cracked-machine/STM32MP1_TestBoard_RevC/STM32MP1_TestBoard_RevC/doc/layout_render/STM32MP1_TestBoard_Back.png

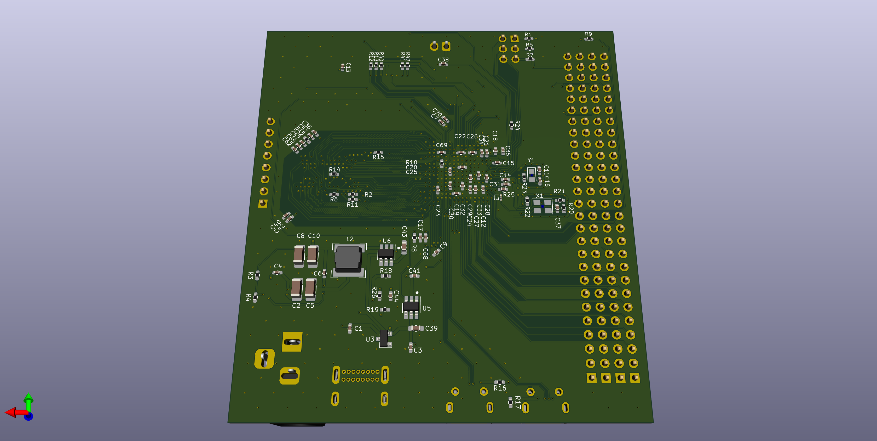
STM32MP1_TestBoard_RevC/doc/layout_render/STM32MP1_TestBoard_Back.png
