cracked-machine/STM32MP1_TestBoard_RevC/STM32MP1_TestBoard_RevC/doc/photos/STM32MP1_A7_boot.jpg

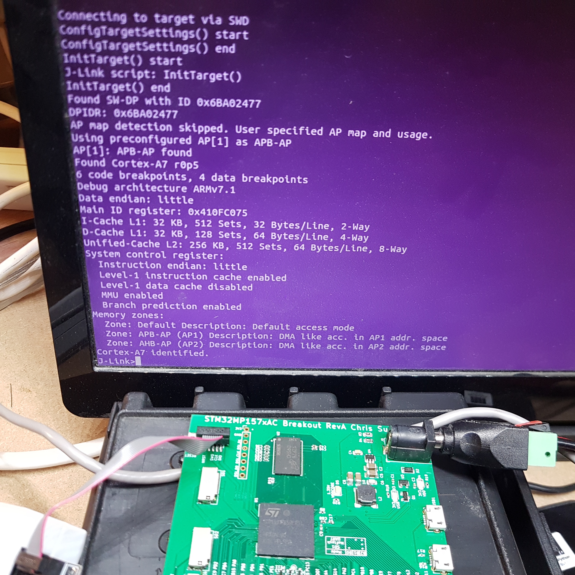
STM32MP1_TestBoard_RevC/doc/photos/STM32MP1_A7_boot.jpg
