cracked-machine/STM32MP1_TestBoard_RevC/STM32MP1_TestBoard_RevC/doc/datasheets/STM32MP1/mb1272_bom/MB1272C/MB1272-DK1-C01_BOM.xlsx

 |  |  | Bill of materials
 |  |  | Board reference: | MB1272
 |  |  | Variant: | DK1
 |  |  | PCB revision: | C
 |  |  | Assembly revision: | 01
 |  |  | Date: | 11/5/2018
Designator | Description | Package | Manufacturer | Manufacturer_Part_Number | Fitted | Quantity
B1, B3, B4 | Switch HW SMD blue |  | JIUBABA | C-TS-02H-2.5-B-V-T/R BLUE | Fitted | 3
B2 | Switch HW SMD black |  | JIUBABA | C-TS-02H-2.5-K-V-T/R BLACK | Fitted | 1
C1, C7, C12, C14, C17, C18, C22, C35, C36, C46, C47, C48, C51, C57, C61, C63, C67, C68, C70, C74, C75, C77, C78, C79, C81, C93, C95, C96, C97, C103, C107, C119, C120, C125, C126, C127, C128, C129, C130, C131, C132, C134, C135, C139, C140, C141, C142, C149, C154, C157, C160, C164, C168, C169, C170, C171, C172, C174, C175, C176, C177, C178, C179, C181, C182, C183, C184, C186, C187, C188 | Capacitor,100nF,16V,X7R,10%,0402, Capacitor,100nF,16V,X7R,10%,0402, Capacitor, MLCC, 100nF, 16V, X7R, 10%, 0402, T=0.5mm, Capacitor,100nF,16V,X7R,10%,0402, Capacitor,100nF,16V,X7R,10%,0402, Capacitor, MLCC, 100nF, 16V, X7R, 10%, 0402, T=0.5mm, Capacitor,100nF,16V,X7R,10%,0402, Capacitor,100nF,16V,X7R,10%,0402, Capacitor,100nF,16V,X7R,10%,0402, Capacitor,100nF,16V,X7R,10%,0402, Capacitor,100nF,16V,X7R,10%,0402, Capacitor,100nF,16V,X7R,10%,0402, Capacitor,100nF,16V,X7R,10%,0402, Capacitor,100nF,16V,X7R,10%,0402, Capacitor,100nF,16V,X7R,10%,0402, Capacitor, MLCC, 100nF, 16V, X7R, 10%, 0402, T=0.5mm, Capacitor, MLCC, 100nF, 16V, X7R, 10%, 0402, T=0.5mm, Capacitor,100nF,16V,X7R,10%,0402, Capacitor,100nF,16V,X7R,10%,0402, Capacitor,100nF,16V,X7R,10%,0402, Capacitor,100nF,16V,X7R,10%,0402, Capacitor,100nF,16V,X7R,10%,0402, Capacitor,100nF,16V,X7R,10%,0402, Capacitor,100nF,16V,X7R,10%,0402, Capacitor,100nF,16V,X7R,10%,0402, Capacitor,100nF,16V,X7R,10%,0402, Capacitor,100nF,16V,X7R,10%,0402, Capacitor,100nF,16V,X7R,10%,0402, Capacitor,100nF,16V,X7R,10%,0402, Capacitor,100nF,16V,X7R,10%,0402, Capacitor,100nF,16V,X7R,10%,0402, Capacitor,100nF,16V,X7R,10%,0402, Capacitor,100nF,16V,X7R,10%,0402, Capacitor,100nF,16V,X7R,10%,0402, Capacitor,100nF,16V,X7R,10%,0402, Capacitor,100nF,16V,X7R,10%,0402, Capacitor,100nF,16V,X7R,10%,0402, Capacitor,100nF,16V,X7R,10%,0402, Capacitor,100nF,16V,X7R,10%,0402, Capacitor,100nF,16V,X7R,10%,0402, Capacitor,100nF,16V,X7R,10%,0402, Capacitor,100nF,16V,X7R,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 | C0402 | YAGEO | CC0402KRX7R7BB104 | Fitted | 70
C10, C16, C20, C23, C26, C31, C32, C33, C49 | Capacitor, MLCC, 4.7uF, 6V3, X5R, 20%, 0402, T=0,5mm | C0402 | MURATA | GRM155R60J475ME47 | Fitted | 9
C100, C101 | Capacitor,150pF,50V,COG,5%,0603 | C0603 | YAGEO | CC0603JRNPO9BN151 | Fitted | 2
C104, C110 | Capacitor,1uF,16V,X5R,10%,0603 | C0603 | YAGEO | CC0603KRX5R7BB105 | Fitted | 2
C106, C113 | Capacitor,22nF,16V,X7R,10%,0402 | C0402 | YAGEO | CC0402KRX7R7BB223 | Fitted | 2
C111 | Capacitor,10uF,6V3,X5R,10%,0603 | C0603 | YAGEO | CC0603KRX5R5BB106 | Fitted | 1
C118, C124, C133, C138 | Capacitor, MLCC, 220uF, 6V3, X5R, 20%, 1206, T=1,6mm | C1206 | MURATA | GRM31CR60J227ME11 | Fitted | 4
C144, C145 | Capacitor,1nF,16V,X7R,10%,0402 | C0402 | YAGEO | CC0402KRX7R7BB102 | Fitted | 2
C15, C27, C39, C62, C64, C65, C72, C73, C89, C94, C102, C105, C108, C109, C112, C143, C146, C147, C148, C150, C152, C153, C155, C156, C158, C159, C161, C162, C163, C165, C191, C192 | Capacitor, MLCC, 1uF, 6V3, X5R, 10%, 0402, T=0,5mm, Capacitor, MLCC, 1uF, 6V3, X5R, 10%, 0402, T=0,5mm, Capacitor, MLCC, 1uF, 6V3, X5R, 10%, 0402, T=0,5mm, Capacitor, MLCC, 1uF, 6V3, X5R, 10%, 0402, T=0,5mm, Capacitor,1uF,6V3,X5R,10%,0402, Capacitor, MLCC, 1uF, 6V3, X5R, 10%, 0402, T=0,5mm, Capacitor,1uF,6V3,X5R,10%,0402, Capacitor,1uF,6V3,X5R,10%,0402, Capacitor,1uF,6V3,X5R,10%,0402, Capacitor,1uF,6V3,X5R,10%,0402, Capacitor,1uF,6V3,X5R,10%,0402, Capacitor,1uF,6V3,X5R,10%,0402, Capacitor,1uF,6V3,X5R,10%,0402, Capacitor,1uF,6V3,X5R,10%,0402, Capacitor,1uF,6V3,X5R,10%,0402, Capacitor,1uF,6V3,X5R,10%,0402, Capacitor,1uF,6V3,X5R,10%,0402, Capacitor,1uF,6V3,X5R,10%,0402, Capacitor,1uF,6V3,X5R,10%,0402, Capacitor,1uF,6V3,X5R,10%,0402, Capacitor,1uF,6V3,X5R,10%,0402, Capacitor,1uF,6V3,X5R,10%,0402, Capacitor,1uF,6V3,X5R,10%,0402, Capacitor,1uF,6V3,X5R,10%,0402, Capacitor,1uF,6V3,X5R,10%,0402, Capacitor,1uF,6V3,X5R,10%,0402, Capacitor,1uF,6V3,X5R,10%,0402, Capacitor,1uF,6V3,X5R,10%,0402, Capacitor,1uF,6V3,X5R,10%,0402, Capacitor,1uF,6V3,X5R,10%,0402, Capacitor,1uF,6V3,X5R,10%,0402, Capacitor,1uF,6V3,X5R,10%,0402 | C0402 | MURATA | GRM155R61E105KA12 | Fitted | 32
C185, C190 | Capacitor,1uF,6V3,X5R,10%,0603 | C0603 | YAGEO | CC0603KRX5R5BB105 | Fitted | 2
C2, C3, C42, C44, C76, C80, C85, C121, C122, C151, C173, C180 | Capacitor, MLCC, 22uF, 6V3, X5R, 20%, 0603, T=0,8mm, Capacitor, MLCC, 22uF, 6V3, X5R, 20%, 0603, T=0,8mm, Capacitor, MLCC, 22uF, 6V3, X5R, 20%, 0603, T=0,8mm, Capacitor, MLCC, 22uF, 6V3, X5R, 20%, 0603, T=0,8mm, Capacitor,22uF,6V3,X5R,20%,0603, Capacitor,22uF,6V3,X5R,20%,0603, Capacitor,22uF,6V3,X5R,20%,0603, Capacitor, MLCC, 22uF, 6V3, X5R, 20%, 0603, T=0,8mm, Capacitor, MLCC, 22uF, 6V3, X5R, 20%, 0603, T=0,8mm, Capacitor,22uF,6V3,X5R,20%,0603, Capacitor,22uF,6V3,X5R,20%,0603, Capacitor,22uF,6V3,X5R,20%,0603 | C0603 | MURATA | GRM188R60J226MEA0J | Fitted | 12
C21, C25, C30, C38, C40, C50, C53, C54, C56, C66, C117, C123, C136, C137 | Capacitor, MLCC, 100nF, 16V, X7R, 10%, 0402, T=0,5mm | C0402 | YAGEO | CC0402KRX7R7BB104 | Fitted | 14
C4, C5, C6, C9, C11, C13, C41, C43 | Capacitor, MLCC, 10uF, 10V, X5R, 10%, 0603, T=0,8mm | C0603 | MURATA | GRM188R61A106KE69D | Fitted | 8
C52 | Polarized Capacitor,10uF,16V,10%,typeA | C1206 | AVX | TAJA106K016R | Fitted | 1
C55 | Capacitor, MLCC, 47uF, 10V, X5R, 20%, 0805, T=1,25mm | C0805 | MURATA | GRM21BR61A476ME15K | Fitted | 1
C58, C59, C87, C88, C90, C91 | Capacitor, MLCC, 6.8pF, 50V, NPO, +-0.25pF, 0402, T=0.5mm | C0402 | YAGEO | CC0402CRNPO9BN6R8 | Fitted | 6
C60 | Capacitor, Tantalum, 47uF, 16V, 10%, TypeC | C2312 | AVX | TAJC476K016RNJ | Fitted | 1
C69, C167 | Capacitor, MLCC, 100pF, 50V, NPO, 5%, 0402, T=0,5mm | C0402 | YAGEO | CC0402JRNPO9BN101 | Fitted | 2
C71, C166 | Capacitor, MLCC, 10uF, 25V, X5R, 10%, 0805, T=0,85mm | C0805 | YAGEO | CC0805KRX5R8BB106 | Fitted | 2
C82, C86, C98, C99 | Capacitor,10pF,50V,NPO,5%,0402 | C0402 | YAGEO | CC0402JRNPO9BN100 | Fitted | 4
C83, C84 | Capacitor, MLCC, 470pF, 50V, NPO, 5%, 0402, T=0,5mm | C0402 | YAGEO | CC0402JRNPO9BN471 | Fitted | 2
C92, C114, C115, C189, C300 | Capacitor, MLCC, 10nF, 16V, X7R, 10%, 0402, T=0.5mm, Capacitor, MLCC, 10nF, 16V, X7R, 10%, 0402, T=0.5mm, Capacitor, MLCC, 10nF, 16V, X7R, 10%, 0402, T=0.5mm, Capacitor,10nF,16V,X7R,10%,0402, Capacitor, MLCC, 10nF, 16V, X7R, 10%, 0402, T=0.5mm | C0402 | YAGEO | CC0402KRX7R7BB103 | Fitted | 5
CN1, CN5 | USB-Receptacle,Dual-Type-A, RA, TH, Height 15.5mm |  | CONEXCON | 5600-3081 | Fitted | 2
CN10 | Connector Jack socket Stereo 3.5mm, 4 pins, RA, SMT, Black |  | LUMBERG | 1503 13 VP3 | Fitted | 1
CN11 | USB-MICRO-B, 0.65mm, RA, SMT, Bottom Mount, |  | MOLEX | 1050170001 | Fitted | 1
CN13 | Socket, 10x1, 2.54mm, VR, SMT, Height 9.78mm |  | SAMTEC | SSW-110-22-L-S-VS | Fitted | 1
CN14, CN16 | Socket, 8x1, 2.54mm, VR, SMT, Height 9.78mm |  | SAMTEC | SSW-108-22-L-S-VS | Fitted | 2
CN15 | MicroSD Card Conn, Reversed-Type, Mnt Push-Push |  | YAMAICHI | PJS008-2003-1 | Fitted | 1
CN17 | Socket, 6x1, 2.54mm, VR, SMT, Height 9.78mm |  | SAMTEC | SSW-106-22-L-S-VS | Fitted | 1
CN2 | Header, 20x2, 2.54mm, VR, TH, Height 5.84mm/2.54mm |  | SAMTEC | TSW-120-07-G-D | Fitted | 1
CN3 | Header 2 circuits, 1.25mm Pitch , Vertical, with Friction Lock |  | MOLEX | 53047-0210 | Fitted | 1
CN4 | Socket ,TEConn,FCC/FPC, 20pins, 1.0mm,SMT, ZIF Receptacle |  | TE CONNECTIVITY | 2-1734248-0 | Fitted | 1
CN6, CN7 | USB tyce C certified receptacle for 1.6mm pcb height |  | CHANT SINCERE (COXOC) | 317JD24BZTF3K3C3 | Fitted | 2
CN8 | Connector RJ45 with Gigabit magnetics and LED , led pull down |  | YUAN DEAN SCIENTIFIC | 48F-01GYDXNL | Fitted | 1
CN9 | HDMI Receptacle Type A 19pins standard Connector |  | FCI | 10029449-001RLF | Fitted | 1
D1, D2 | BAT60JFILM |  | STMICROELECTRONICS | BAT60JFILM | Fitted | 2
F1 | Surface mount resettable polyswitch fuse.I hold=0.35A and I trigger=0.75A | 0805 | TE CONNECTIVITY | picoSMDC035S | Fitted | 1
HW1300 | MICRO_SD_CARD Standard min 4GB |  | NETAC | SD_CARD | Fitted | 1
HW1301 | PCB, xxxx for PCB ref, Y for revision |  | n/a | n/a | Fitted | 1
HW1302 | Sticker to mention board CPN code |  | n/a | n/a | Fitted | 1
HW1303 | Sticker to mention board reference + serial number |  | n/a | n/a | Fitted | 1
L10, L11 | Ferrite bead 100R 2A 0603 |  | MURATA | BLM18EG101TN1 | Fitted | 2
L2, L3, L5, L6 | Power Inductor ,1µH,4.3A max,+-20%,0.042ohm,2520 | 2520 | MURATA | DFE252012P-1ROM=P2 | Fitted | 4
L7 | SMD Chip ferrite bead, 30R@100MHz +/-30%, 5A, 10mohm DC, S (Standard) material, 0603, T=0.8mm |  | TDK | MPZ1608S300A | Fitted | 1
L8 | Bead,26R at 100Mhz,6A,0603 |  | MURATA | BLM18KG260TN1 | Fitted | 1
L9 | IND 4.7µH 20% 80mA 600mhom 0603 | 0603 | MURATA | LQM18FN4R7M00D | Fitted | 1
LD1, LD6 | LED, Red, 0603 | LED 0603 | EVERLIGHT | 19-213-R6C-AP1Q2B/3T | Fitted | 2
LD2, LD3, LD5, LD9 | LED, Green, 0603 | LED 0603 | EVERLIGHT | 19-213SYGC/S530-E2/TR8 | Fitted | 4
LD4 | LED Bicolor |  | AVAGO TECHNOLOGIES | HSMF-A201-A00J1 | Fitted | 1
LD7 | LED, Orange, 0603 | LED 0603 | EVERLIGHT | 19-217/S2C-AM2N2VY/3T | Fitted | 1
LD8 | LED Blue, 0603 SMD, Forward Voltage Min=2,8V, Max=3,1V | 0603 | EVERLIGHT | 19-217-BHC-ZL1M2RY-3T | Fitted | 1
LE1 | FIXED IND 4.7UH 1A 180 MOHM 30% SMD |  | MURATA | LQH32PN4R7NN0L | Fitted | 1
Q1 | Transistor 45V Matched Pair PNP small Signal transistor in SOT363 | SOT363 | DIODES_INC | BCM857BS7F | Fitted | 1
Q2, T1, T2 | Power Mosfet, P-channel,VDS -30V,RDS 12mohm typ,ID -9A | PowerFLAT 3.3x3.3 | STMICROELECTRONICS | STL9P3LLH6 | Fitted | 3
R1, R2, R5, R7, R65, R75, R76, R93, R166, R167 | Resistor,1K5,0402,1%,1/16W | R0402 | YAGEO | RC0402FR-071K5L | Fitted | 10
R107, R108 | Resistor,680R,0402,1%,1/16W | R0402 | YAGEO | RC0402FR-07680RL | Fitted | 2
R11, R18, R19, R37, R40, R42, R80, R81, R84, R87, R96, R99, R109, R136, R164, R300, R302, R600 | Resistor,10K,0402,1%,1/16W | R0402 | YAGEO | RC0402FR-0710KL | Fitted | 18
R112 | Resistor,36K,0402,1%,1/16W | R0402 | YAGEO | RC0402FR-0736KL | Fitted | 1
R115, R116, R117, R118, R121, R122, R123, R124, R126, R128, R130, R131, R132, R133, R135, R138, R141, R142, R143, R144, R145, R146, R147, R148 | Resistor,56R,0402,1%,1/16W | R0402 | YAGEO | RC0402FR-0756RL | Fitted | 24
R14, R16, R25, R28, R33, R39, R45, R49, R56, R120 | Resistor,47K,0402,1%,1/16W | R0402 | YAGEO | RC0402FR-0747KL | Fitted | 10
R15, R38 | Resistor,240R,0402,1%,1/16W | R0402 | YAGEO | RC0402FR-07240RL | Fitted | 2
R155 | Resistor,2K49,0402,1%,1/16W | R0402 | YAGEO | RC0402FR-072K49L | Fitted | 1
R21, R43, R82, R101, R102, R106, R303 | Resistor,1K,0402,1%,1/16W | R0402 | YAGEO | RC0402FR-071KL | Fitted | 7
R23, R100, R119, R127, R129, R134, R137, R139, R140, R159, R161 | Resistor,100K,0402,1%,1/16W | R0402 | YAGEO | RC0402FR-07100KL | Fitted | 11
R24 | Resistor,12K,0402,1%,1/16W | R0402 | YAGEO | RC0402FR-0712KL | Fitted | 1
R3, R47, R150 | Resistor,0R,0603,ULO | R0603 | ROHM | PMR03EZPJ000 | Fitted | 3
R304 | Resistor,10R,0402,1%,1/16W | R0402 | YAGEO | RC0402FR-0710RL | Fitted | 1
R4, R6, R8, R10, R13, R31, R34, R35, R36, R46, R58, R59, R64, R68, R71, R72, R73, R77, R79, R85, R86, R152, R154, R158, R165 | Resistor,0R,0402,5%,1/16W | R0402 | YAGEO | RC0402JR-070RL | Fitted | 25
R41, R89, R90, R105 | Resistor,330R,0402,1%,1/16W | R0402 | YAGEO | RC0402FR-07330RL | Fitted | 4
R44 | Resistor,3K,0402,1%,1/16W | R0402 | YAGEO | RC0402FR-073KL | Fitted | 1
R48, R57, R70 | Resistor,5K1,0402,1%,1/16W | R0402 | YAGEO | RC0402FR-075K1L | Fitted | 3
R50, R51, R52, R53, R54, R55, R67, R91, R94, R149, R156, R163 | Resistor,4K7,0402,1%,1/16W | R0402 | YAGEO | RC0402FR-074K7L | Fitted | 12
R60, R61, R62, R63, R153 | Resistor,22R,0402,1%,1/16W | R0402 | YAGEO | RC0402FR-0722RL | Fitted | 5
R66, R114, R157, R162 | Resistor,510R,0402,1%,1/16W | R0402 | YAGEO | RC0402FR-07510RL | Fitted | 4
R83, R151, R160 | Resistor,0R,0603,5%,1/10W | R0603 | YAGEO | RC0603JR-070RL | Fitted | 3
R88, R104, R110, R111, R125 | Resistor,100R,0402,1%,1/16W | R0402 | YAGEO | RC0402FR-07100RL | Fitted | 5
R92, R103 | Resistor,51R,0402,1%,1/16W | R0402 | YAGEO | RC0402FR-0751RL | Fitted | 2
R95, R97, R98 | Resistor,2K2,0402,1%,1/16W | R0402 | YAGEO | RC0402FR-072K2L | Fitted | 3
SB1, SB2, SB3, SB4, SB5, SB6, SB9, SB10, SB17, SB19, SB20, SB21, SB22, SB24, SB26 | Solder Bridge ON | SB0603 | YAGEO | RC0603JR-070RL | Fitted | 15
SW1 | Dip Switch ,2Position ,Surface Mount Slide (Standard) ,2.54 pitch,25mA 24VDC | DIP | C&K | SDA02H1SBD | Fitted | 1
T3, T4 | NPN Bipolar Transistor |  | ON SEMICONDUCTOR | BSR14 | Fitted | 2
TP10, TP13, TP14 | Test Point 0.6mm |  |  |  | Fitted | 3
U1, U2, U6, U9, U29 | Common mode filter with ESD protection for USB 2.0 interface |  | STMICROELECTRONICS | ECMF02-2AMX6 | Fitted | 5
U10, U26 | 4-line ESD protection for high speed lines | uQFN-10L | STMICROELECTRONICS | HSP051-4M10 | Fitted | 2
U12 | USB Type-C controller with VCONN switch |  | STMICROELECTRONICS | STUSB1600AQTR | Fitted | 1
U13 | MPU TFBGA12x12 without crypto | TFBGA12x12 | STMICROELECTRONICS | STM32MP157AAC3 | Fitted | 1
U14 | HDMI Transmitter, 72-pin 10 × 10 mm QFN |  | LATTICE | SiI9022ACNU | Fitted | 1
U15, U17 | DUAL TRANSIL ARRAY FOR ESD PROTECTION | ESD_SOT23 | STMICROELECTRONICS | ESDA25L | Fitted | 2
U16, U23, U24, U25, U27, U28, U30 | High power transient voltage suppressor | QFN1610 | STMICROELECTRONICS | ESDA7P120-1U1M | Fitted | 7
U18 | 10/100/1000M GIGABIT Ethernet Transceiver, QFN40 , SMPS version |  | REALTEK | RTL8211F-CG | Fitted | 1
U19 | Medium-density performance line ARM-based 32-bit MCU with 128KB Flash |  | STMICROELECTRONICS | STM32F103CBT6 | Fitted | 1
U20 | Low-Power, Stereo Codec with Headphone Amp |  | CIRRUS LOGIC | CS42L51-CNZ | Fitted | 1
U21 | USB OTG FS ESD protection |  | STMICROELECTRONICS | USBLC6-2P6 | Fitted | 1
U22 | Quad Bidir ESD protection |  | STMICROELECTRONICS | ESDA6V1BC6 | Fitted | 1
U3, U11 | IC,Dual-Channel-Power-Switch,500mA,100mR,SO8 |  | STMICROELECTRONICS | STMPS2252MTR | Fitted | 2
U31, U32 | ESD protection & Common Filter High Speed serial Interfaces |  | STMICROELECTRONICS | ECMF04-4HSWM10 | Fitted | 2
U33 | ESD protection , 5 lines | QFN | STMICROELECTRONICS | ESDALC6V1-5M6 | Fitted | 1
U34 | Ultra low drop-low noise BiCMOS voltage, regulators low ESR capacitors compatible |  | STMICROELECTRONICS | LD3985M33R | Fitted | 1
U35 | ESD protection 6V1 |  | STMICROELECTRONICS | ESDALC6V1-1U2 | Fitted | 1
U4 | ST PMIC: 4 step-down + 1 advanced boost SMPS, 6 LDOs, 2 pwr switches, DDR Vref, NVM option 'A' for IO@3.3V | WFQFN 5.0x6.0x0.80mm | STMICROELECTRONICS | STPMIC1APQR | Fitted | 1
U5 | Memory,DDR3L,4Gb,256Mbx16,1866MT/s,1V35,FBGA96 |  | MICRON | MT41K256M16TW-107-P-V00H | Fitted | 1
U7 | USB HUB 2,0 Controller |  | MICROCHIP | USB2514B-AEZC | Fitted | 1
X1 | Crystal 24MHz, 6pF, +-20ppm, 80ohms max, SMD | (2016) 2.0 x 1.6 x 0.45 mm | NDK | NX2016SA 24MHz EXS00A-CS10820 | Fitted | 1
X2 | Crystal 25Mhz, 10pF, -+50PPM, SMD | 3225 | NDK | NX3225GA 25MHz EXS00A-CG06750 | Fitted | 1
X4 | Crystal 32.768kHz, 6pF, -+20PPM, R=80K, SMD | NX2012SA | NDK | NX2012SA 32.768KHz EXS00A-MU00527 | Fitted | 1
X5 | Crystal 8Mhz, 8pF, -+50PPM, SMD |  | NDK | NX3225GD 8MHz EXS00A-CG04874 | Fitted | 1
X6 | Oscillator 24Mhz, +-50ppm, Vcc:3.3V typ (1.62V min), square wave: [0.1Vcc;0.9Vcc], Enable pin | 2.0x1.6x0.7mm | NDK | NZ2016SH 24MHz END4869F | Fitted | 1
C28 | Capacitor, MLCC, 2.2uF, 10V, X5R, 10%, 0603, T=0,8mm | C0603 | YAGEO | CC0603KRX5R6BB225 | Not Fitted | 0
C29 | Capacitor, MLCC, 10uF, 10V, X5R, 10%, 0603, T=0,8mm | C0603 | MURATA | GRM188R61A106KE69D | Not Fitted | 0
C37 | Capacitor, MLCC, 4.7uF, 6V3, X5R, 20%, 0402, T=0,5mm | C0402 | MURATA | GRM155R60J475ME47 | Not Fitted | 0
C45 | Capacitor,100nF,16V,X7R,10%,0402 | C0402 | YAGEO | CC0402KRX7R7BB104 | Not Fitted | 0
C8, C19, C24, C34 | Capacitor, MLCC, 12pF, 50V, NPO, 5%, 0402, T=0,5mm | C0402 | YAGEO | CC0402JRNPO9BN120 | Not Fitted | 0
CN12 | Header, 4x1, 2,54mm, VR, TH, Height 5.84mm/2.54mm |  | SAMTEC | TSW-104-07-x-S | Not Fitted | 0
L1 | Inductor,2.4nH,+-0.2nH,0.05R,0.85A,0402 | L0402 | MURATA | LQW15AN2N4C00x | Not Fitted | 0
L4 | Inductor, 2.2µH, 20%, Isat 0.35A, DCR 0.2Ohm, 0603 | L0603 | MURATA | LQM18PN2R2MGH | Not Fitted | 0
R12, R17, R20, R22, R26, R27 | Resistor,47K,0402,1%,1/16W | R0402 | YAGEO | RC0402FR-0747KL | Not Fitted | 0
R69 | Resistor,22R,0402,1%,1/16W | R0402 | YAGEO | RC0402FR-0722RL | Not Fitted | 0
R9, R32, R74, R78 | Resistor,0R,0402,5%,1/16W | R0402 | YAGEO | RC0402JR-070RL | Not Fitted | 0
SB23, SB25 | Solder Bridge ON | SB0603 | YAGEO | RC0603JR-070RL | Not Fitted | 0
SB7, SB8, SB11, SB12, SB13, SB14, SB15, SB16, SB18 | Solder Bridge OFF | SB0603 | YAGEO | RC0603JR-070RL | Not Fitted | 0
U8 | IEEE802.11b/g/n W-LAN + Bluetooth 4.1+EDR module |  | MURATA | LBEE5KL1DX-883 | Not Fitted | 0
