cracked-machine/STM32MP1_TestBoard_RevC/STM32MP1_TestBoard_RevC/doc/3d/DC Power Jack 5.5mm x 2.1mm.STEP

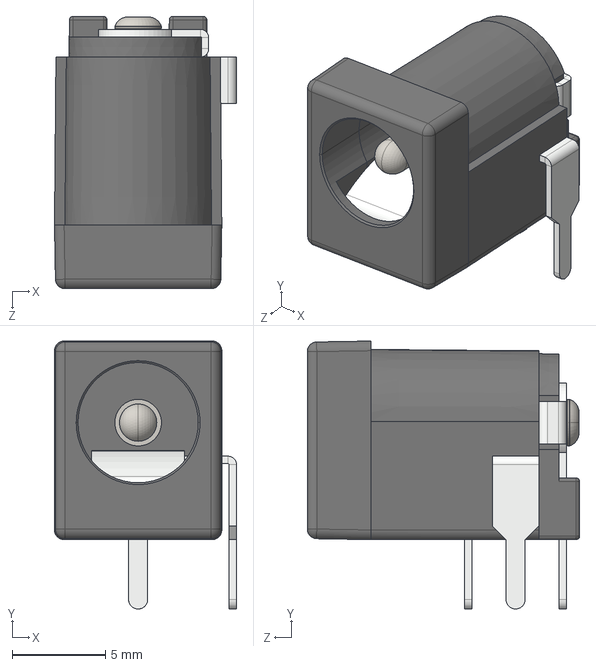
[picture p3: CAD file, 2021-06-18]
STM32MP1_TestBoard_RevC/doc/3d/DC Power Jack 5.5mm x 2.1mm.STEP
9.77 x 14.4 x 14.6 mm
