cracked-machine/STM32MP1_TestBoard_RevC/STM32MP1_TestBoard_RevC/doc/3d/EVQ-9P7_P34-01P.STEP

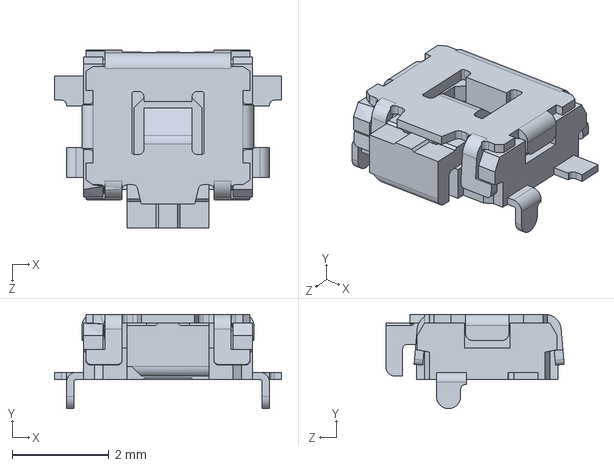
[picture p4: CAD file, 2021-06-18]
STM32MP1_TestBoard_RevC/doc/3d/EVQ-9P7_P34-01P.STEP
4.70 x 1.95 x 3.69 mm
