cracked-machine/STM32MP1_TestBoard_RevC/STM32MP1_TestBoard_RevC/doc/3d/DM3BT-DSF-PEJS.stp

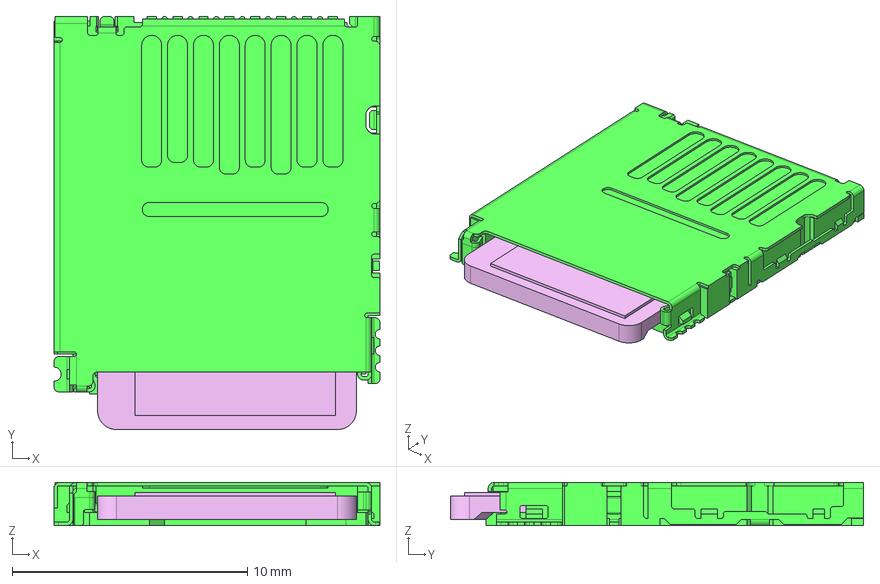
[picture p5: CAD file, 2021-06-18]
STM32MP1_TestBoard_RevC/doc/3d/DM3BT-DSF-PEJS.stp
13.8 x 17.6 x 1.83 mm
CARD
DM3BT
