cracked-machine/STM32MP1_TestBoard_RevC/STM32MP1_TestBoard_RevC/doc/3d/1040310811.stp

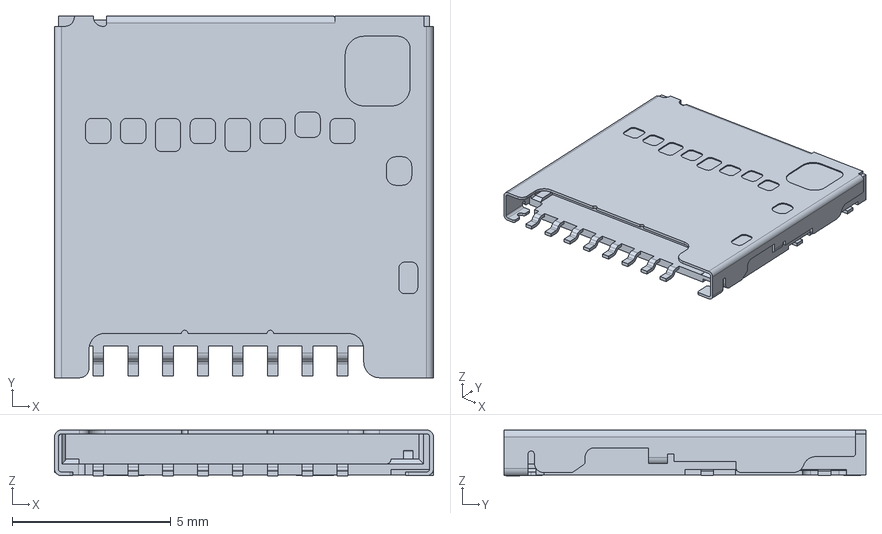
[picture p6: CAD file, 2021-06-18]
STM32MP1_TestBoard_RevC/doc/3d/1040310811.stp
11.9 x 11.4 x 1.45 mm
