cracked-machine/STM32MP1_TestBoard_RevC/STM32MP1_TestBoard_RevC/doc/3d/2137160001.stp

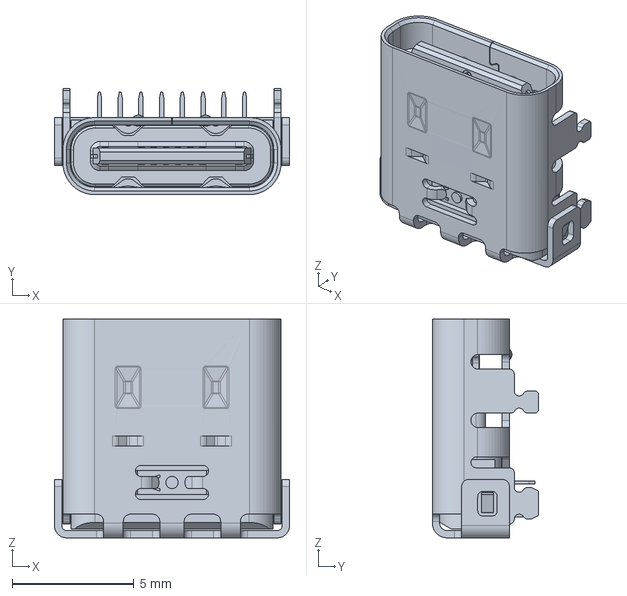
[picture p7: CAD file, 2021-06-18]
STM32MP1_TestBoard_RevC/doc/3d/2137160001.stp
9.64 x 4.36 x 8.97 mm
