cracked-machine/STM32MP1_TestBoard_RevC/STM32MP1_TestBoard_RevC/doc/3d/1050170001.stp

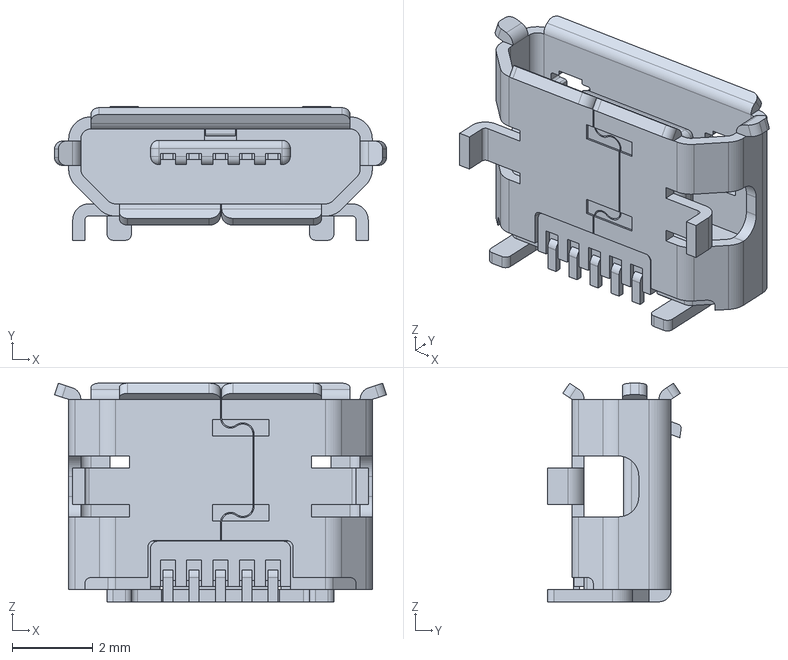
[picture p8: CAD file, 2021-06-18]
STM32MP1_TestBoard_RevC/doc/3d/1050170001.stp
8.20 x 3.30 x 5.40 mm
