cracked-machine/STM32MP1_TestBoard_RevC/STM32MP1_TestBoard_RevC/doc/3d/475710001.stp

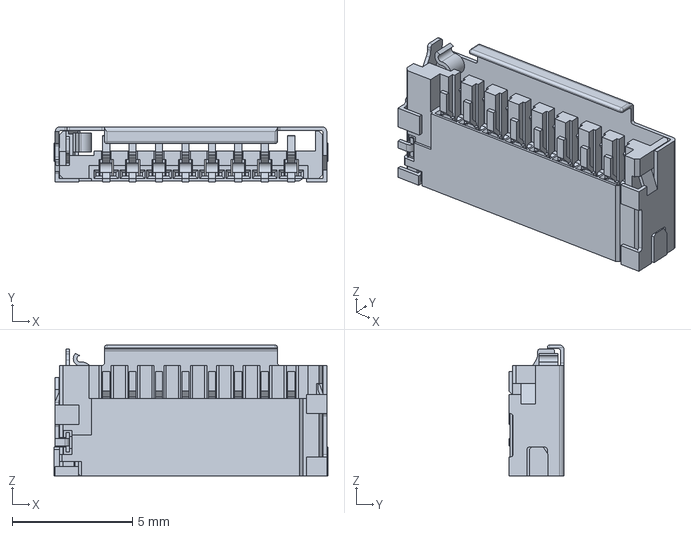
[picture p9: CAD file, 2021-06-18]
STM32MP1_TestBoard_RevC/doc/3d/475710001.stp
11.4 x 2.30 x 5.45 mm
