cracked-machine/STM32MP1_TestBoard_RevC/STM32MP1_TestBoard_RevC/doc/datasheets/PWR/SIP3250_2.png

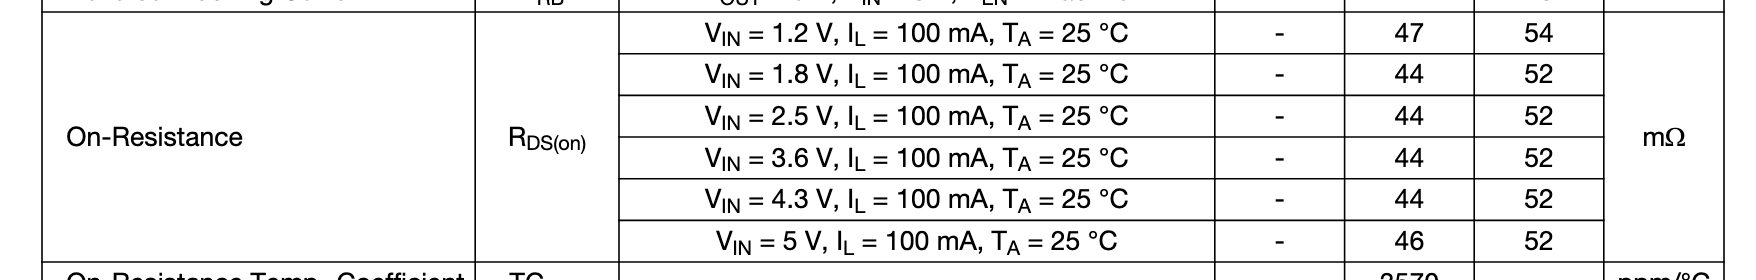
STM32MP1_TestBoard_RevC/doc/datasheets/PWR/SIP3250_2.png
