cracked-machine/STM32MP1_TestBoard_RevC/STM32MP1_TestBoard_RevC/doc/layout_render/TIMERPADDING=100.png

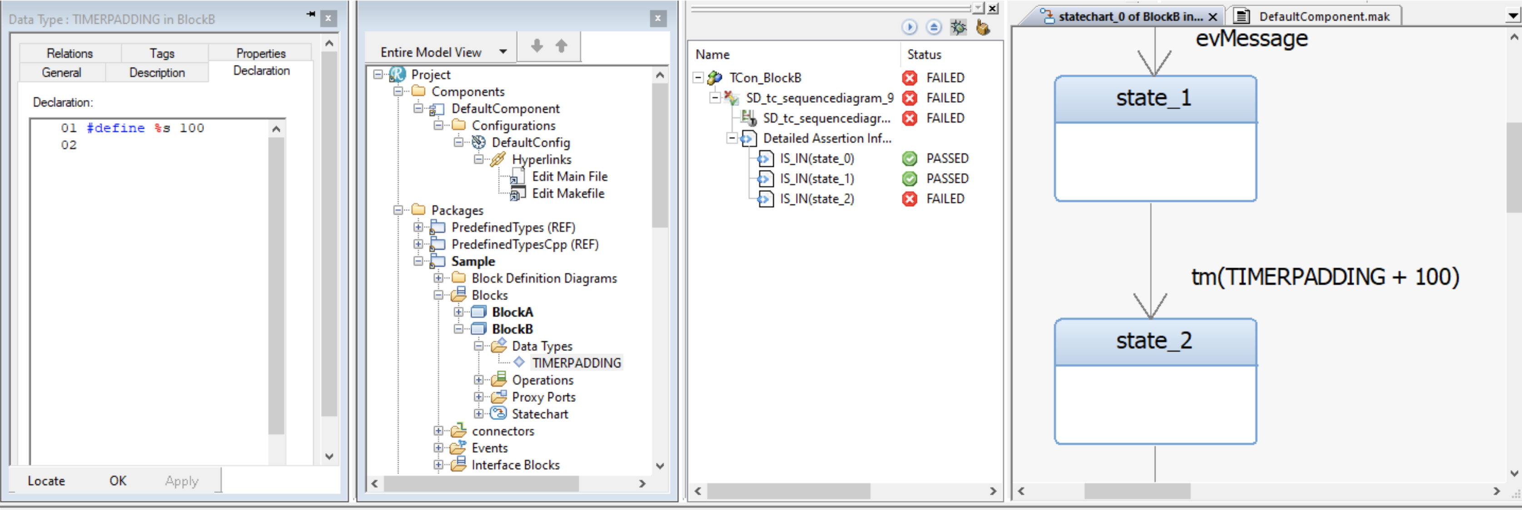
STM32MP1_TestBoard_RevC/doc/layout_render/TIMERPADDING=100.png
