cracked-machine/STM32MP1_TestBoard_RevC/STM32MP1_TestBoard_RevC/doc/UART_Pin_Map/STM32MP157xAC_LFBGA35_BreakoutBoard_Pin_List.png

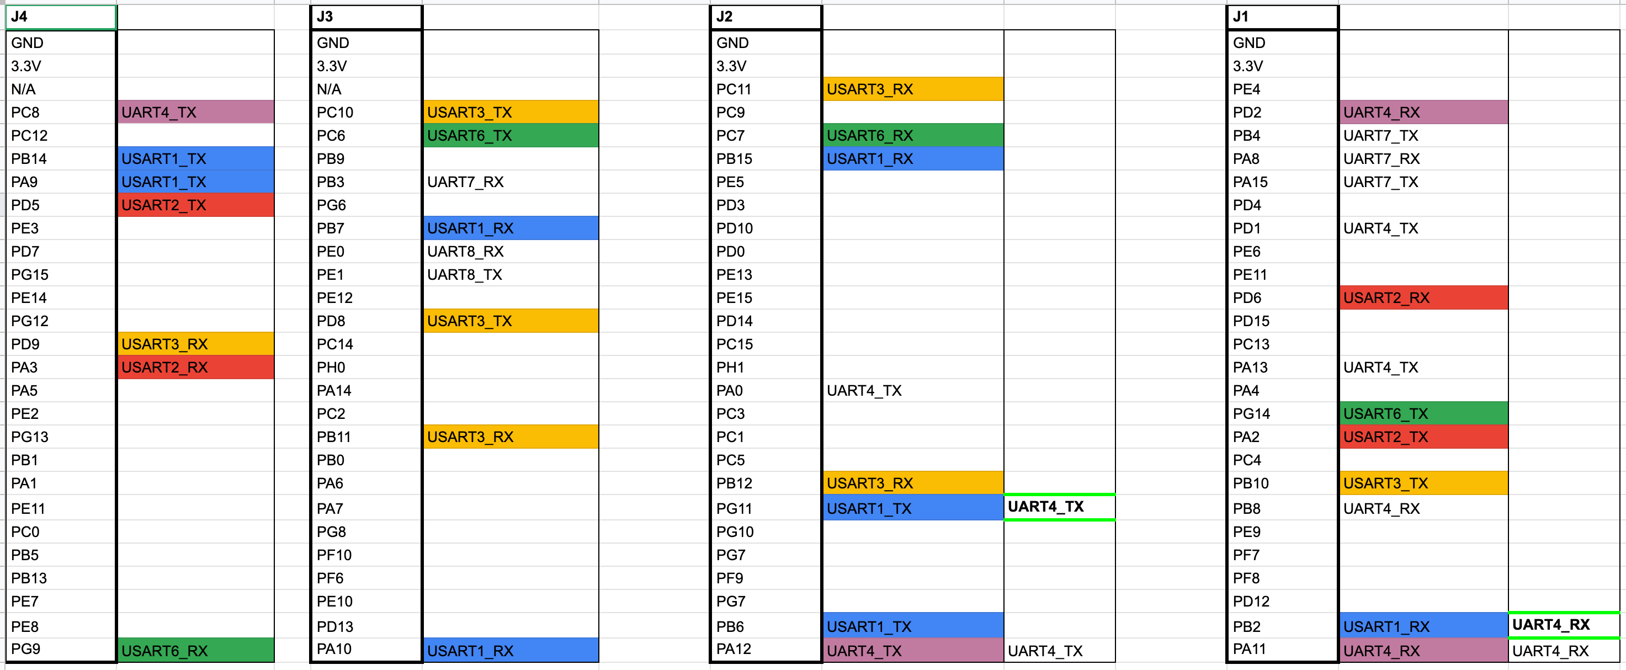
STM32MP1_TestBoard_RevC/doc/UART_Pin_Map/STM32MP157xAC_LFBGA35_BreakoutBoard_Pin_List.png
