cracked-machine/STM32MP1_TestBoard_RevC/STM32MP1_TestBoard_RevC/doc/schema/STM32MP1_TestBoard_RevC.pdf

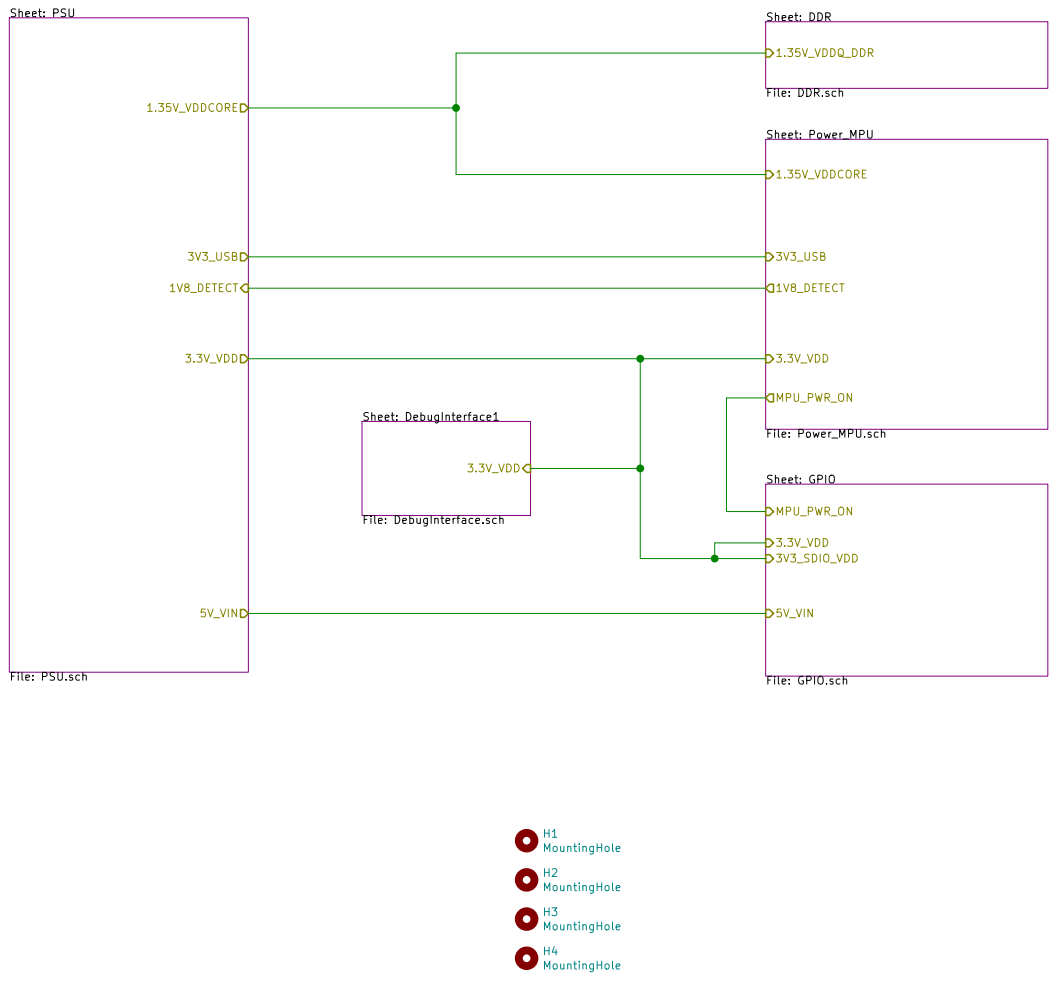
[picture p16: page 1]

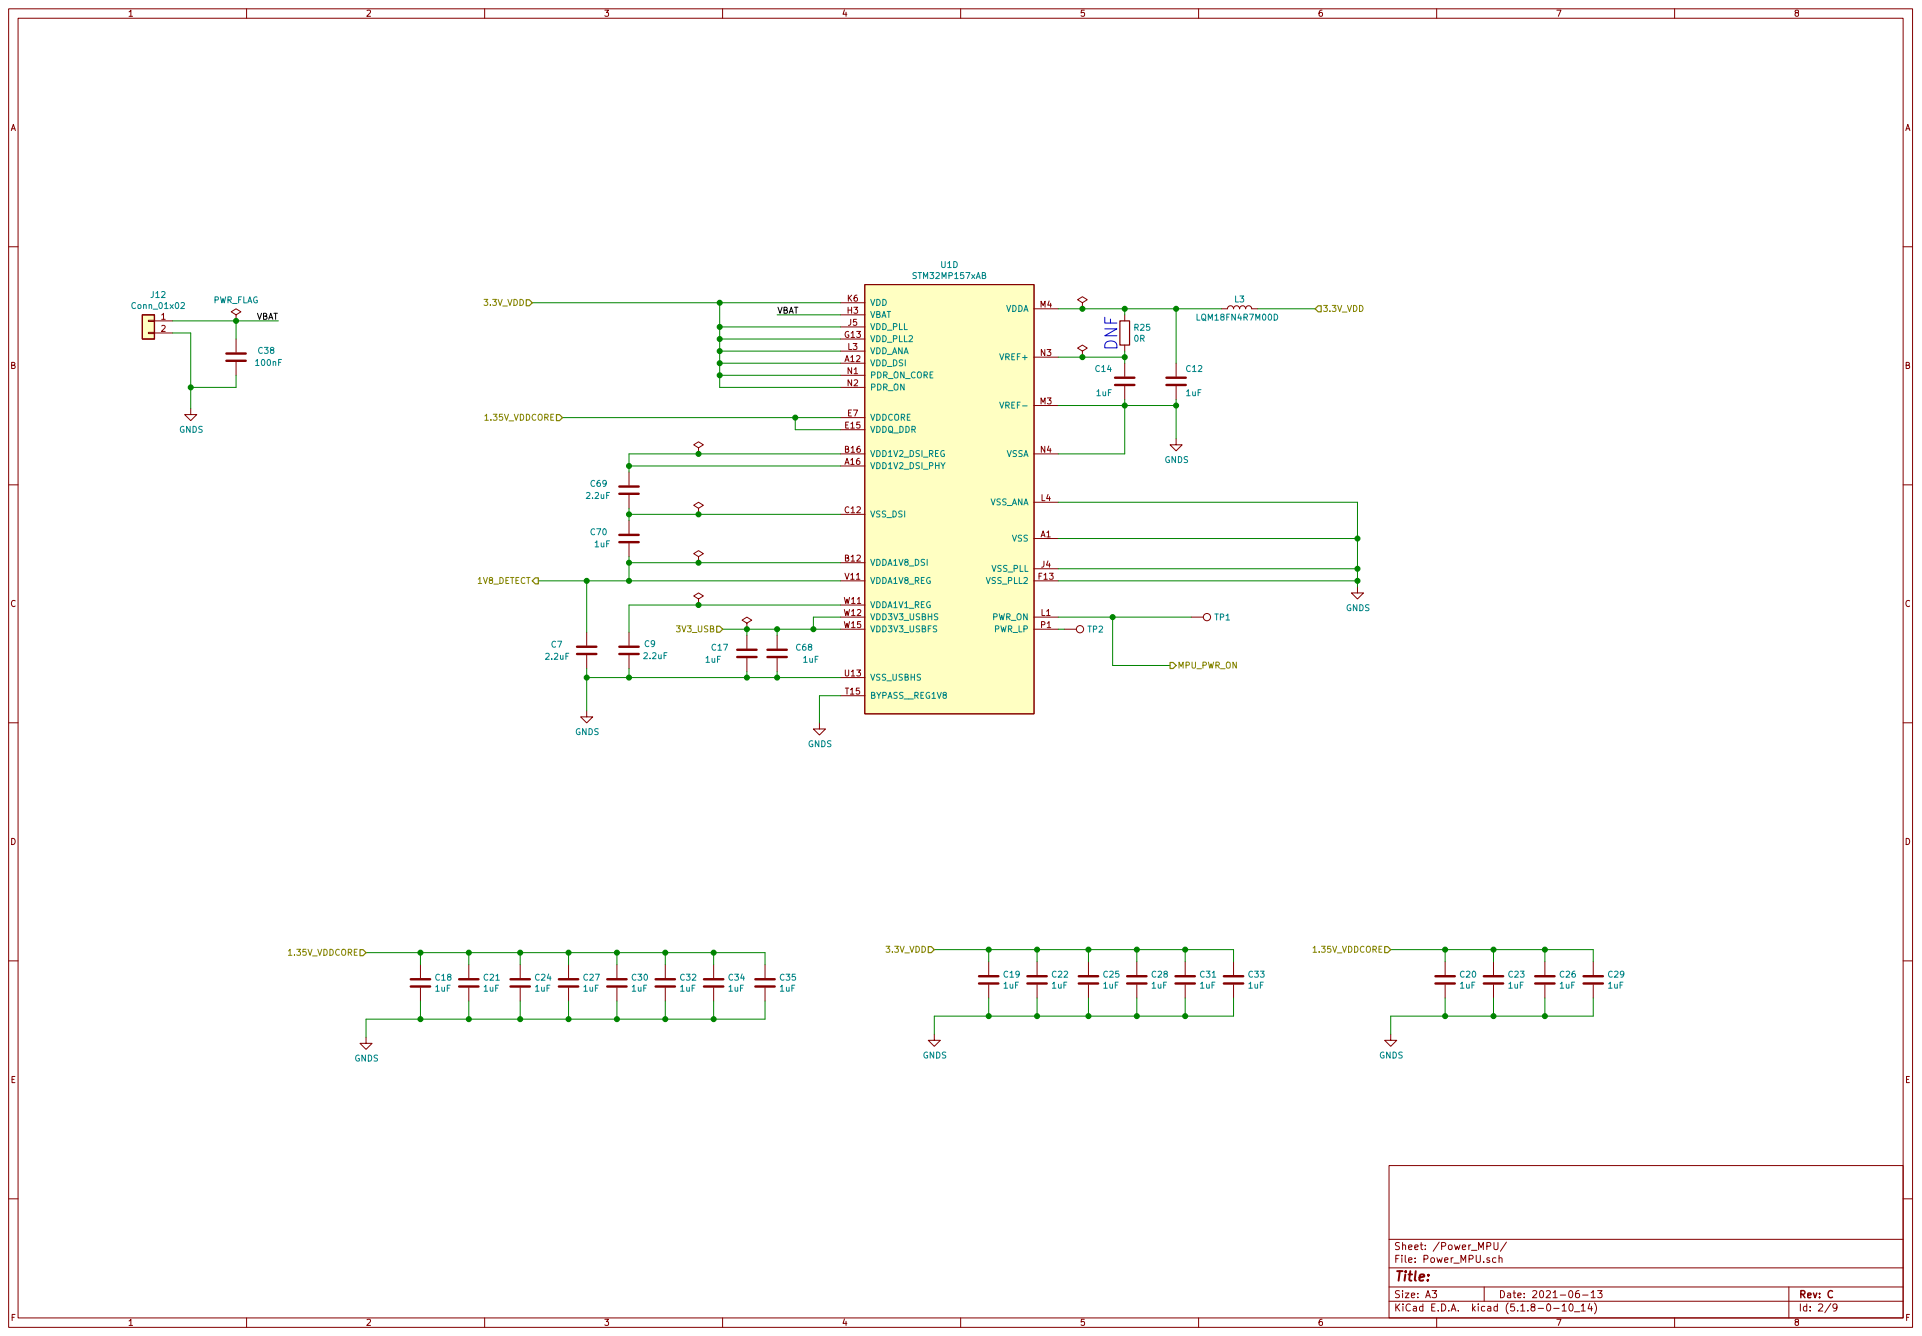
[picture p17: page 2]

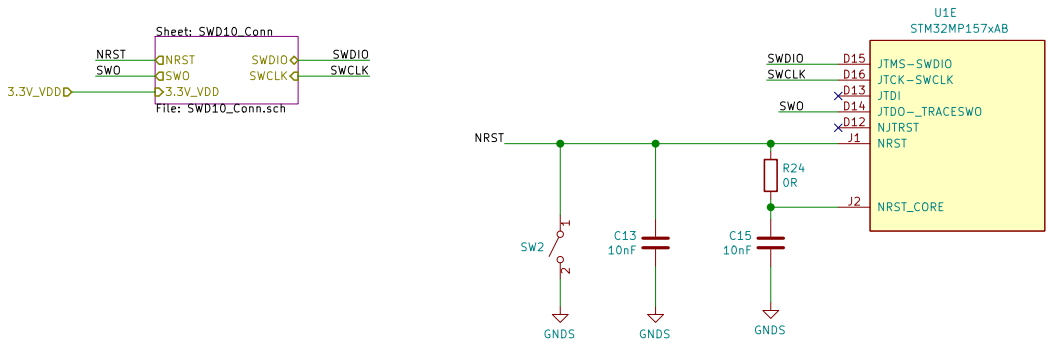
[picture p18: page 3]

Sheet: SWD10_Conn File: SWD10_Conn.sch SWCLK

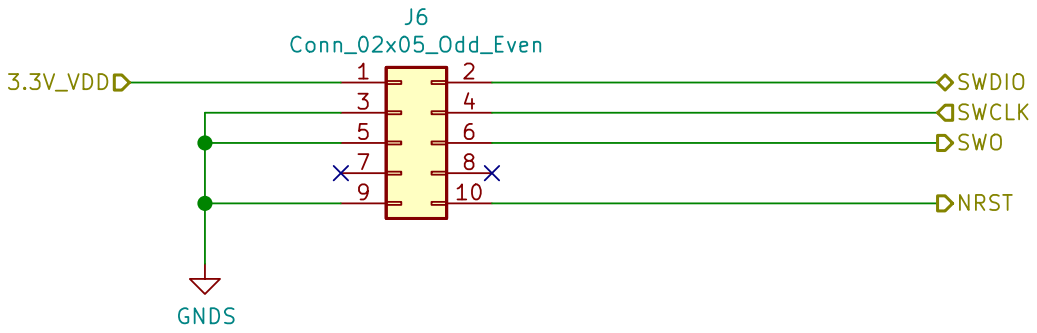
[picture p19: page 4]

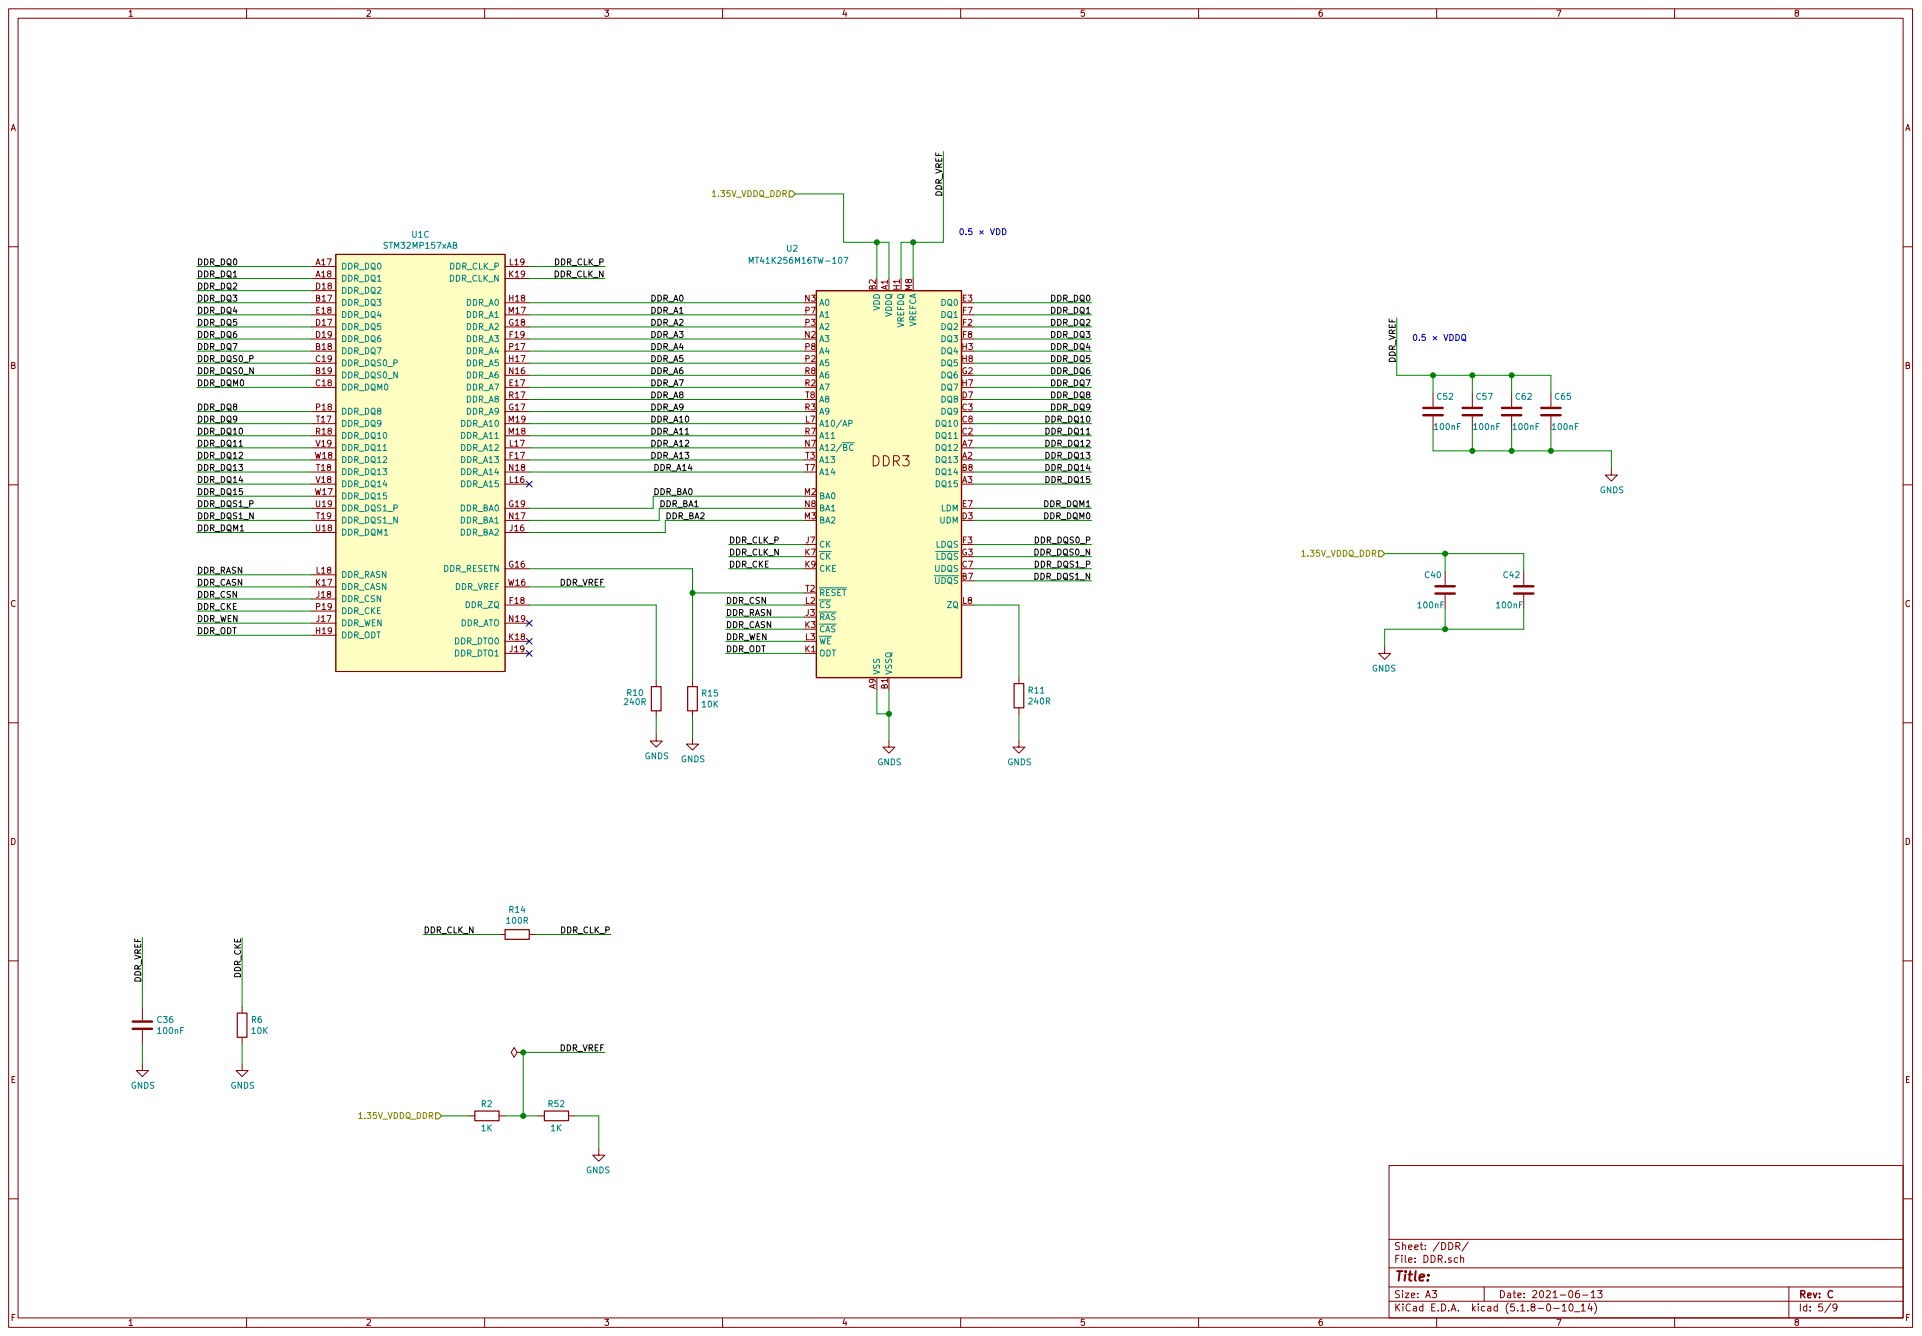
[picture p20: page 5]

Id: 5/9 Title: File: DDR.sch Sheet: /DDR/

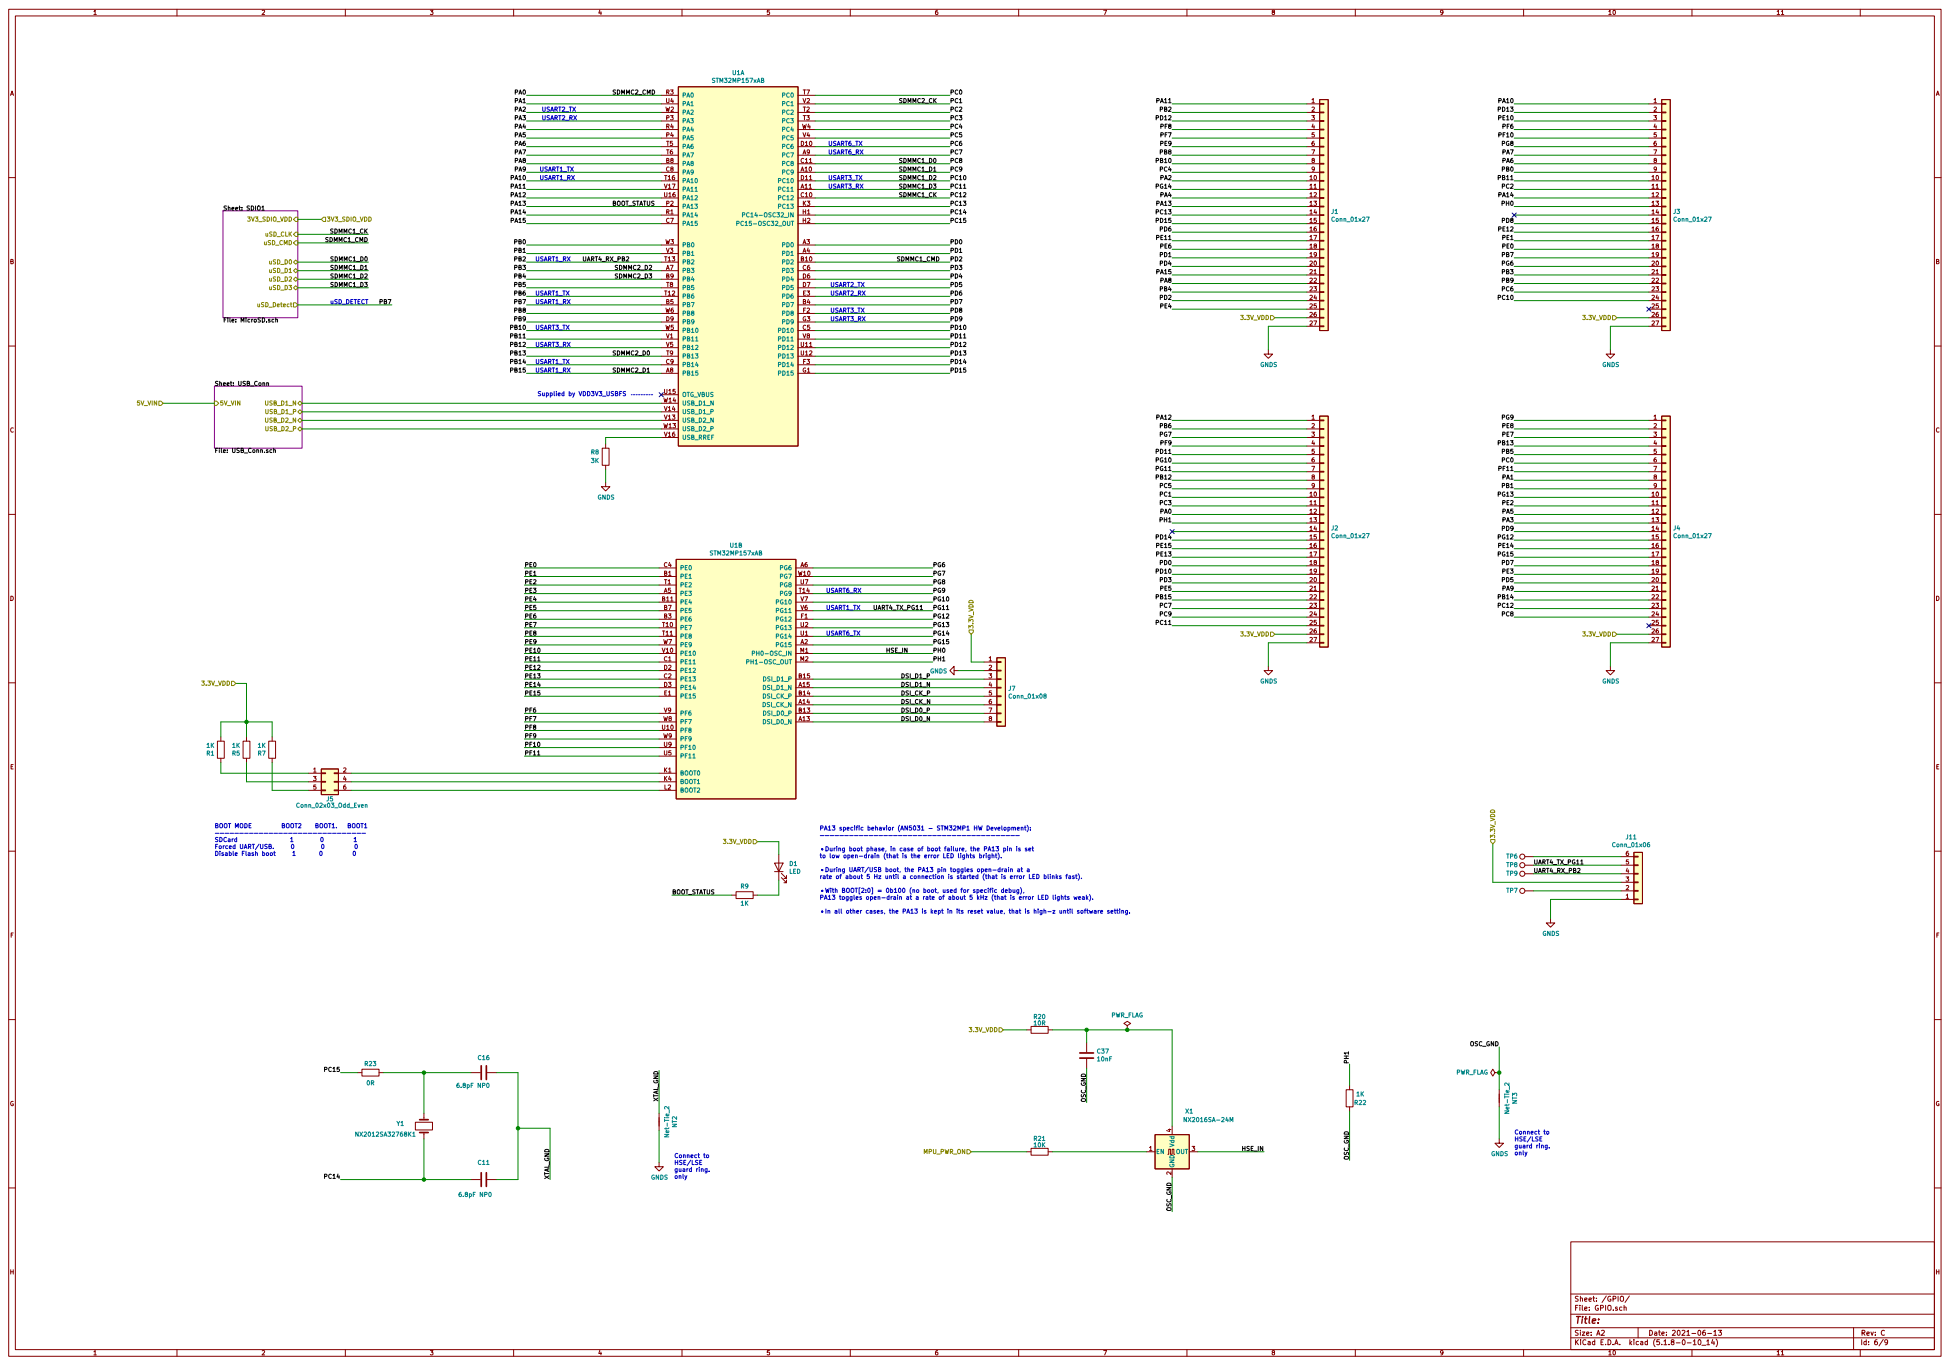
[picture p21: page 6]

Sheet: SDIO1 File: MicroSD.sch

PA13 specific behavior (AN5031 - STM32MP1 HW Development):

During boot phase, in case of boot failure, the PA13 pin is set
to low open-drain (that is the error LED lights bright).

During UART/USB boot, the PA13 pin toggles open-drain at a
rate of about 5 Hz until a connection is started (that is error LED blinks fast).

With BOOT[2:0] = 0b100 (no boot, used for specific debug),
PA13 toggles open-drain at a rate of about 5 kHz (that is error LED lights weak).

In all other cases, the PA13 is kept in its reset value, that is high-z until software setting.

Connect to HSE/LSE

Id: 6/9 Title: File: GPIO.sch Sheet: /GPIO/

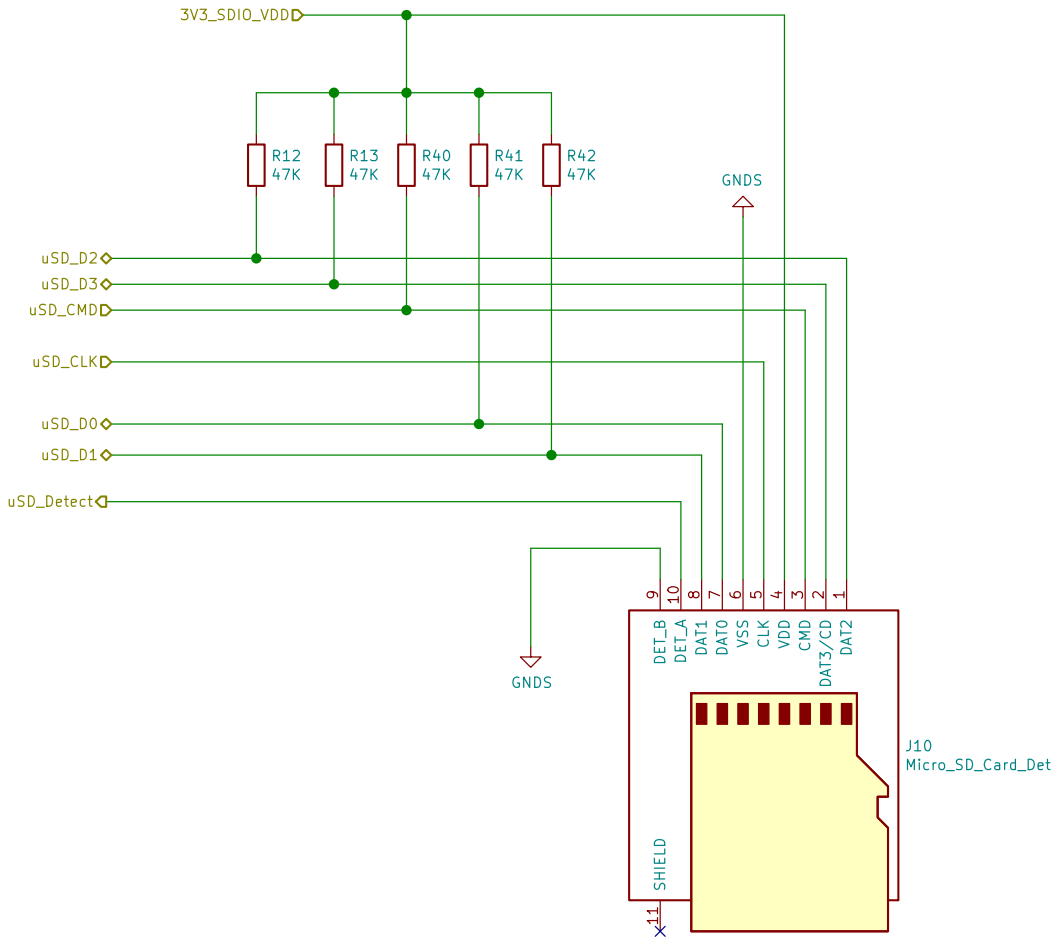
[picture p22: page 7]

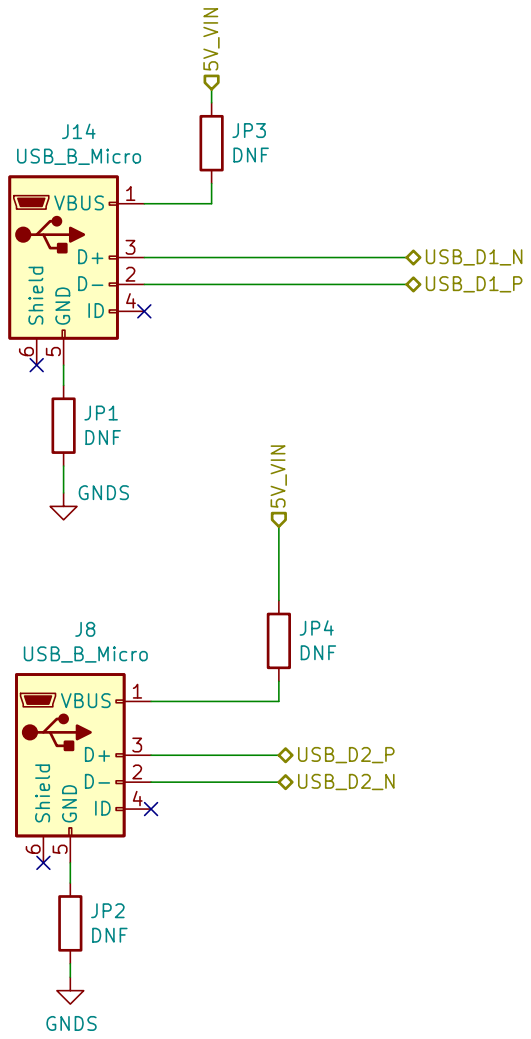
[picture p23: page 8]

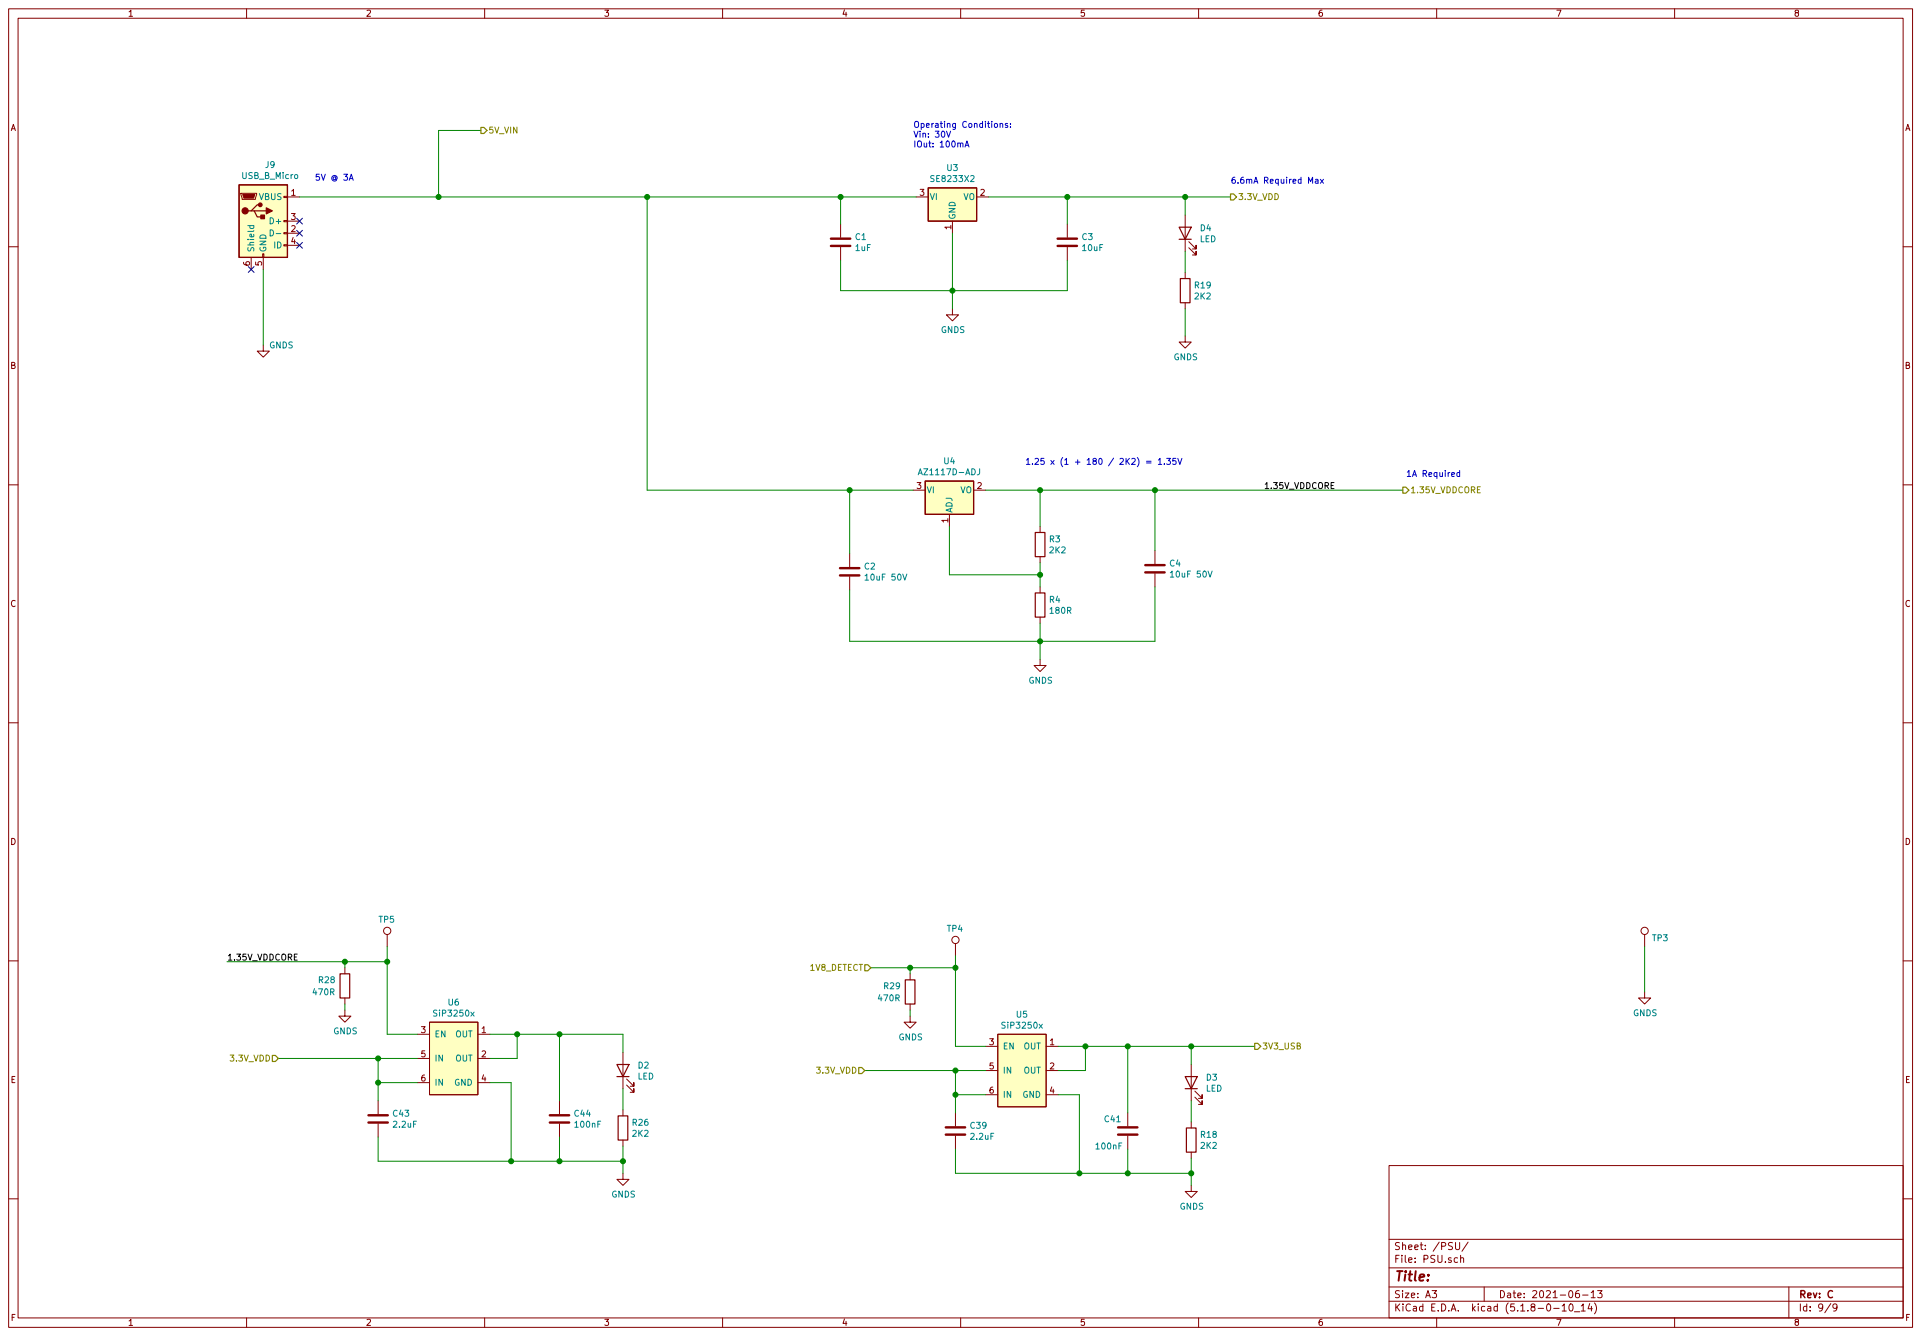
[picture p24: page 9]

Id: 9/9 Title: File: PSU.sch Sheet: /PSU/
