cracked-machine/STM32MP1_TestBoard_RevC/STM32MP1_TestBoard_RevC/doc/schema/STM32MP1_TestBoard_RevB.pdf

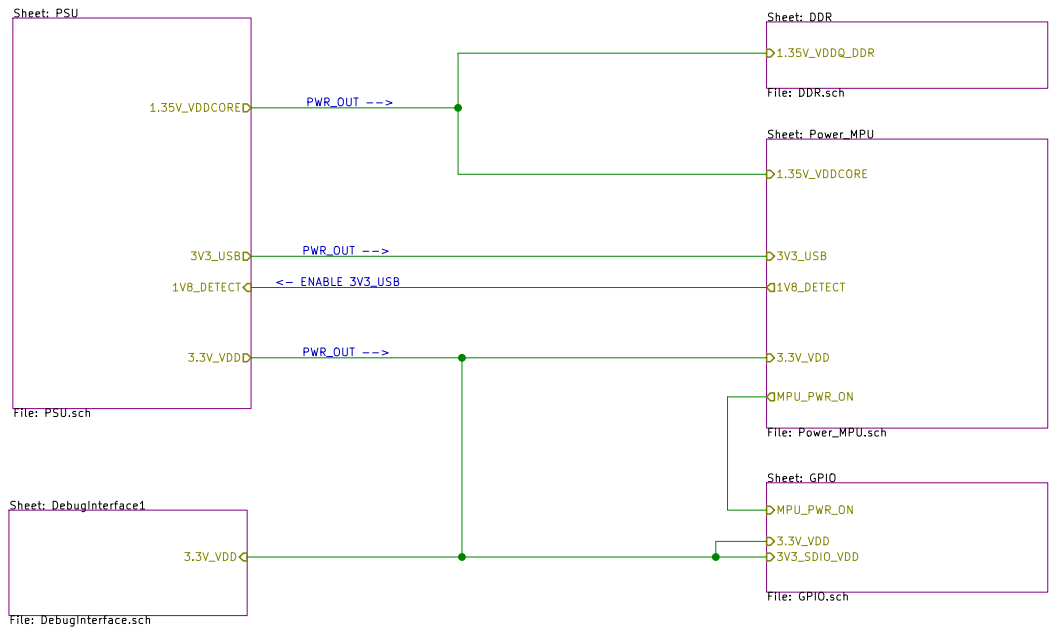
[picture p25: page 1]

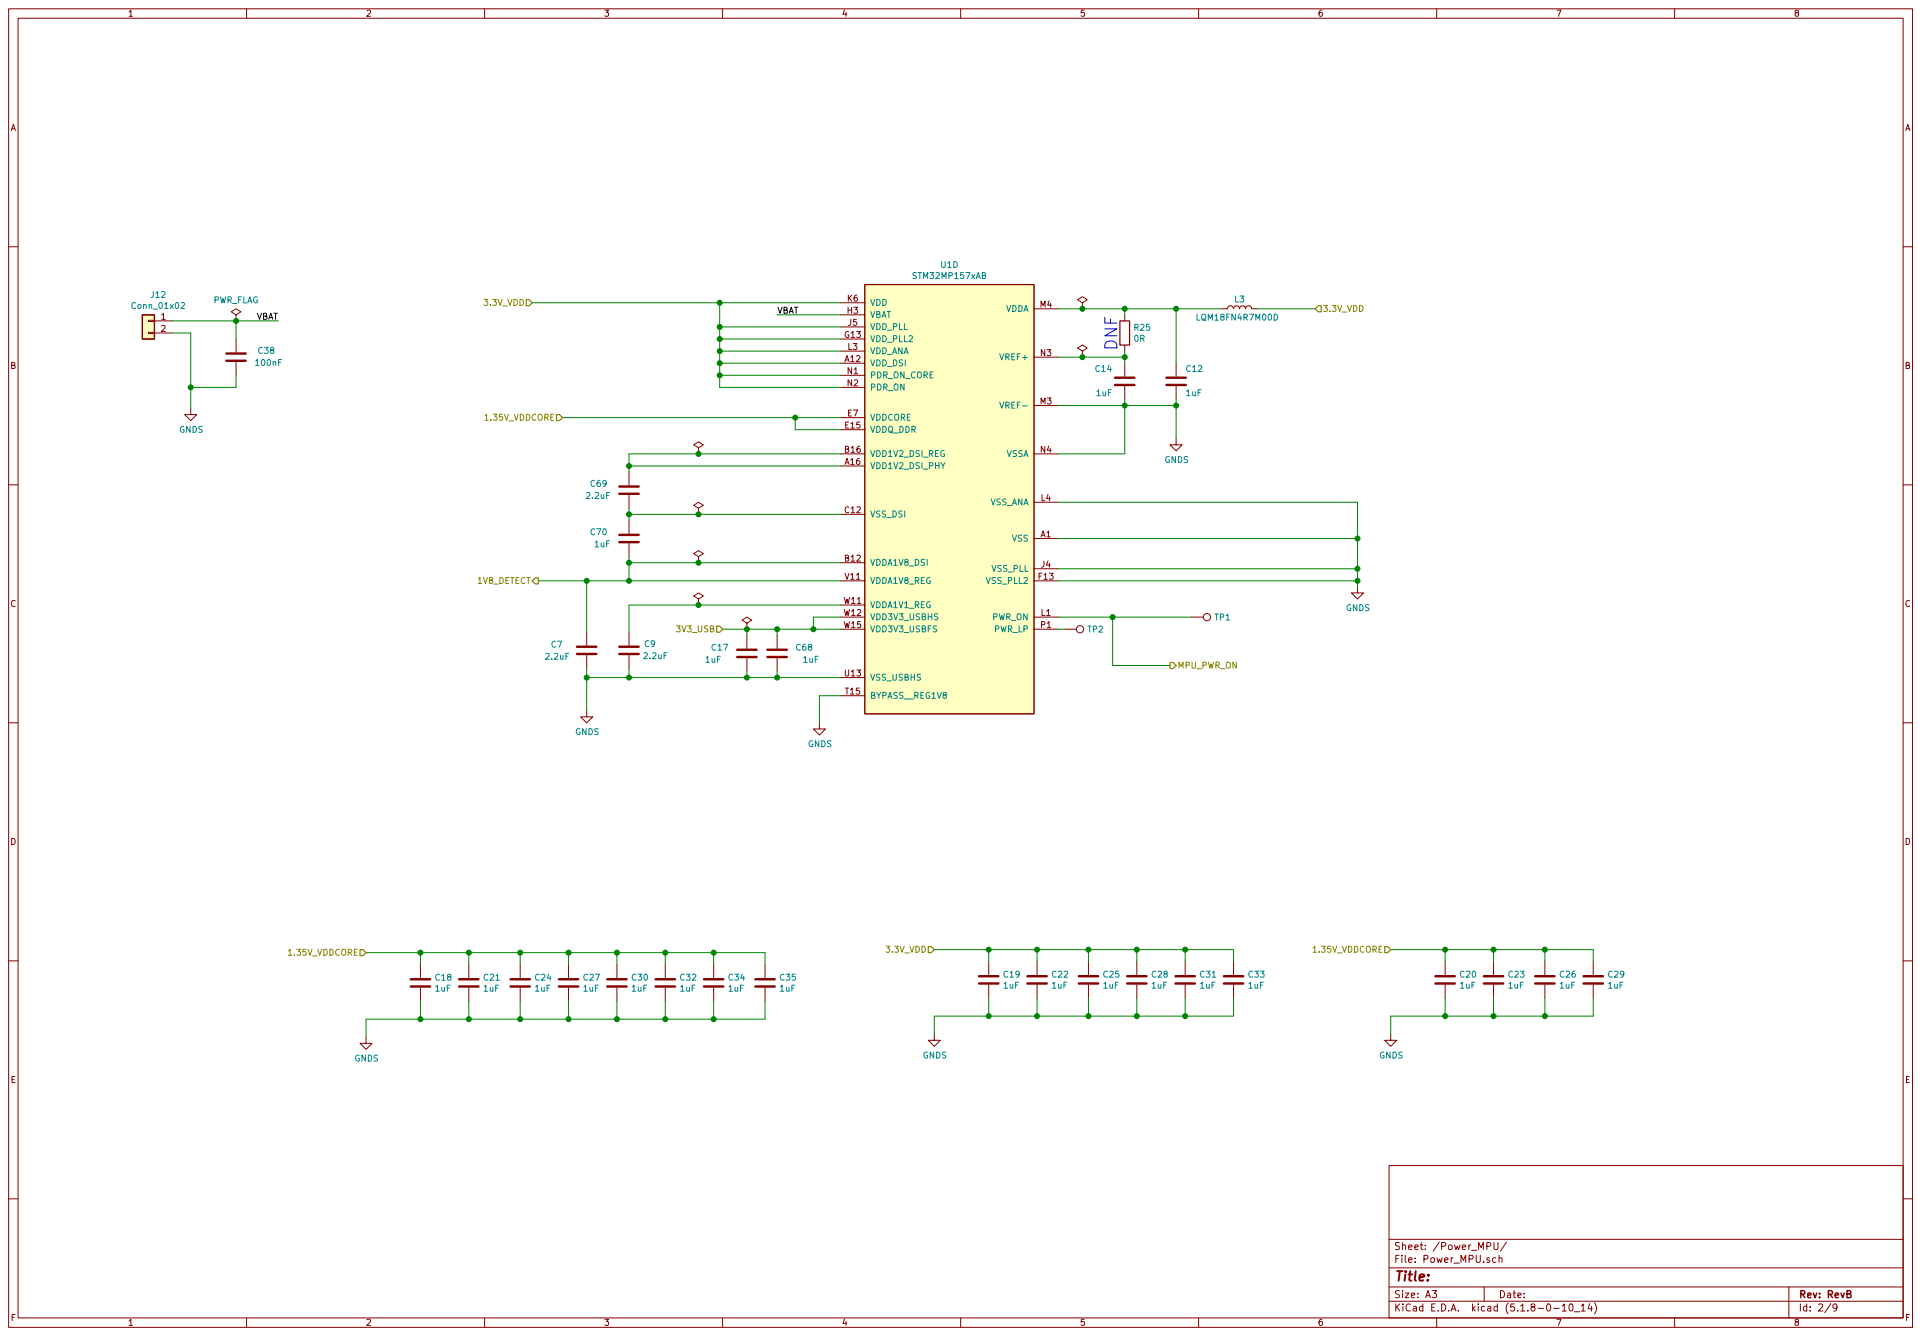
[picture p26: page 2]

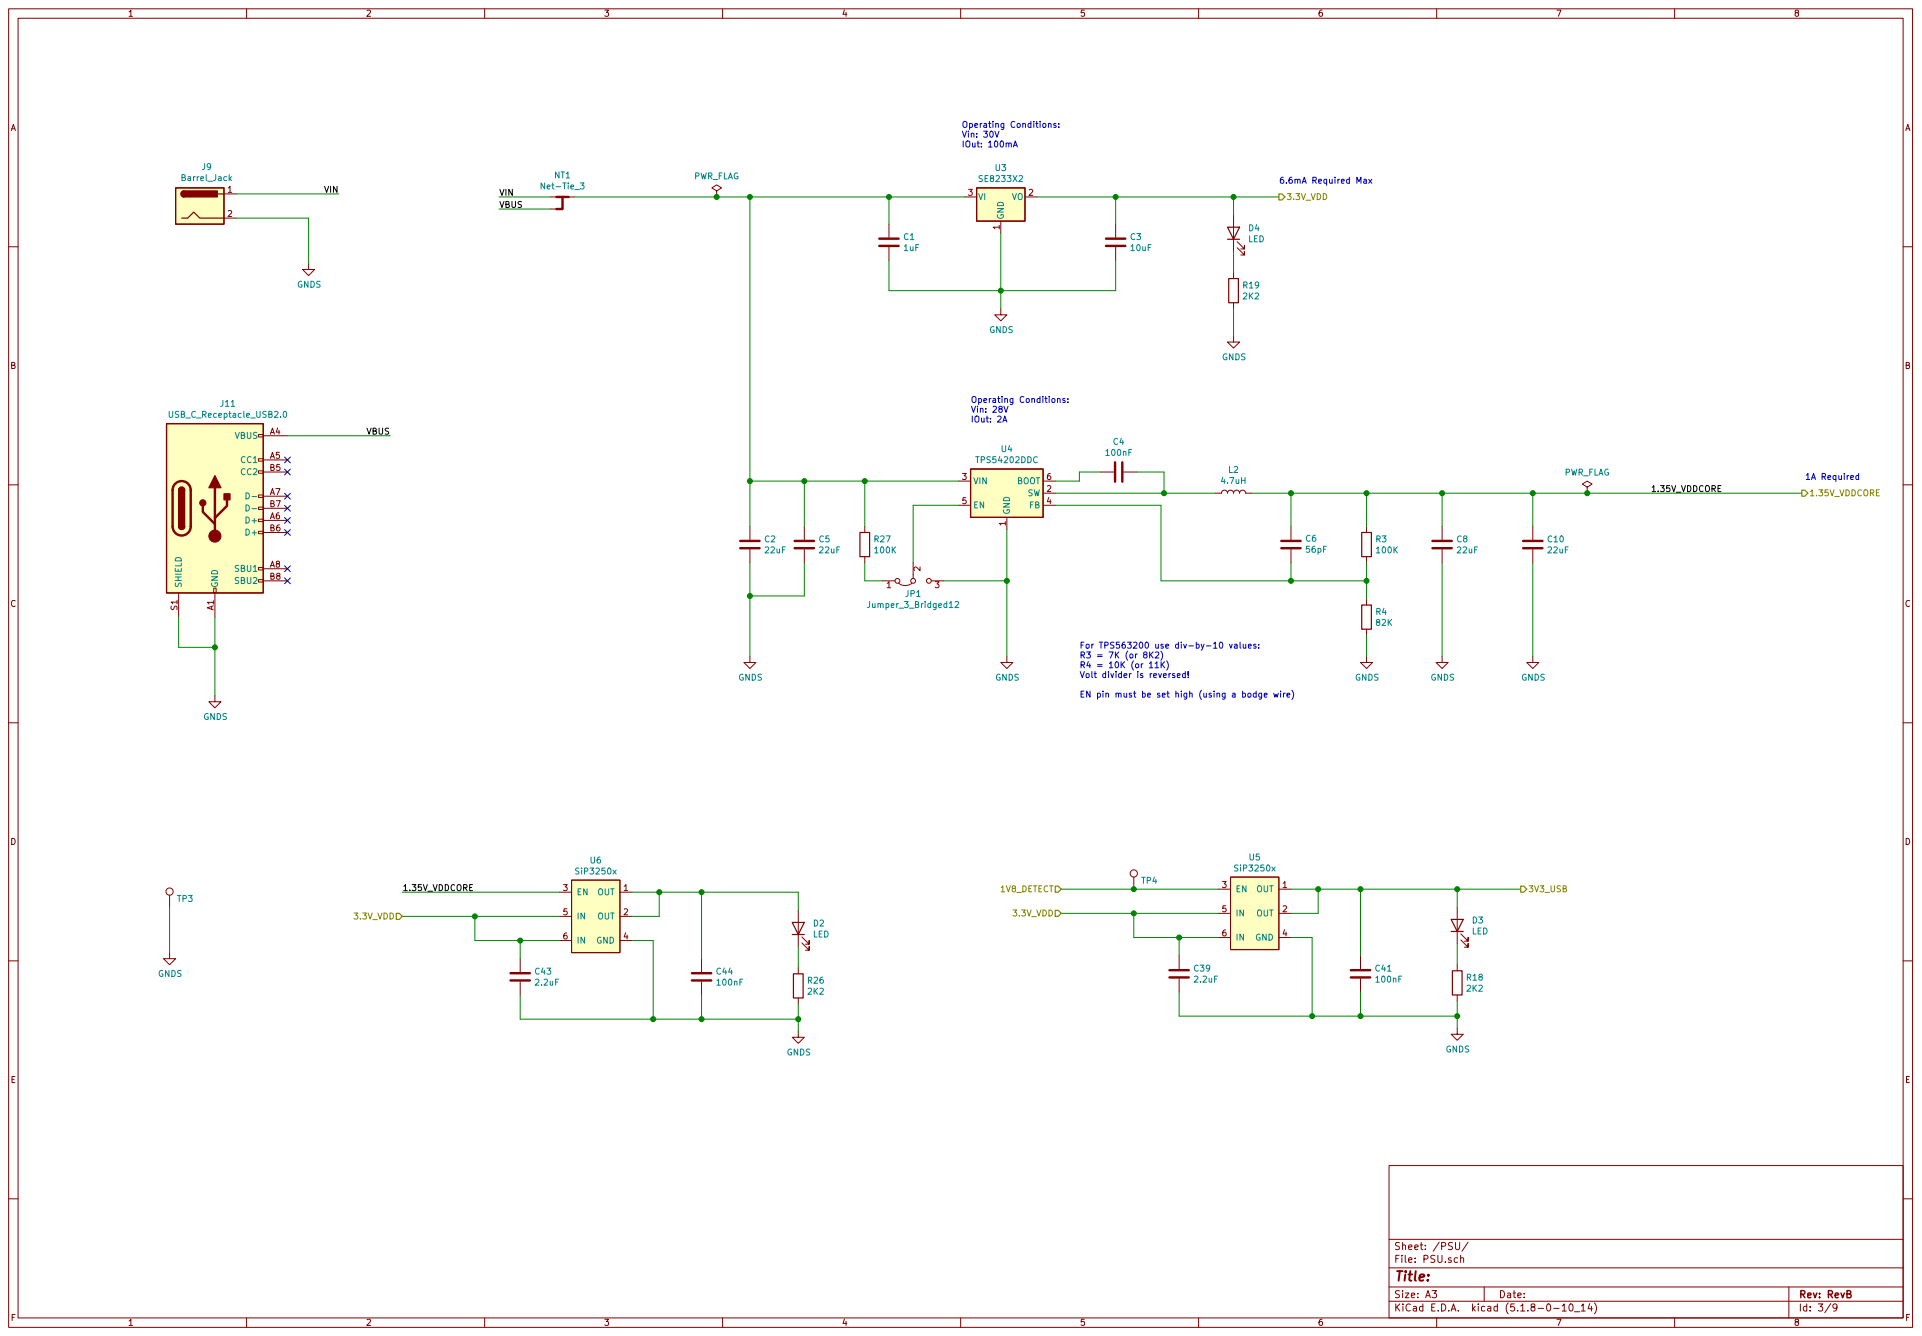
[picture p27: page 3]

Operating Conditions: Vin: 30V
IOut: 100mA Operating Conditions: Vin: 28V

1 SW 2 VIN 3 FB 4 EN 5 BOOT 6 U4 TPS54202DDC

Id: 3/9 Title: File: PSU.sch Sheet: /PSU/ GND

For TPS563200 use div-by-10 values:
R4 = 10K (or 11K) Volt divider is reversed! EN pin must be set high (using a bodge wire)


Sheet: SWD10_Conn File: SWD10_Conn.sch SWCLK


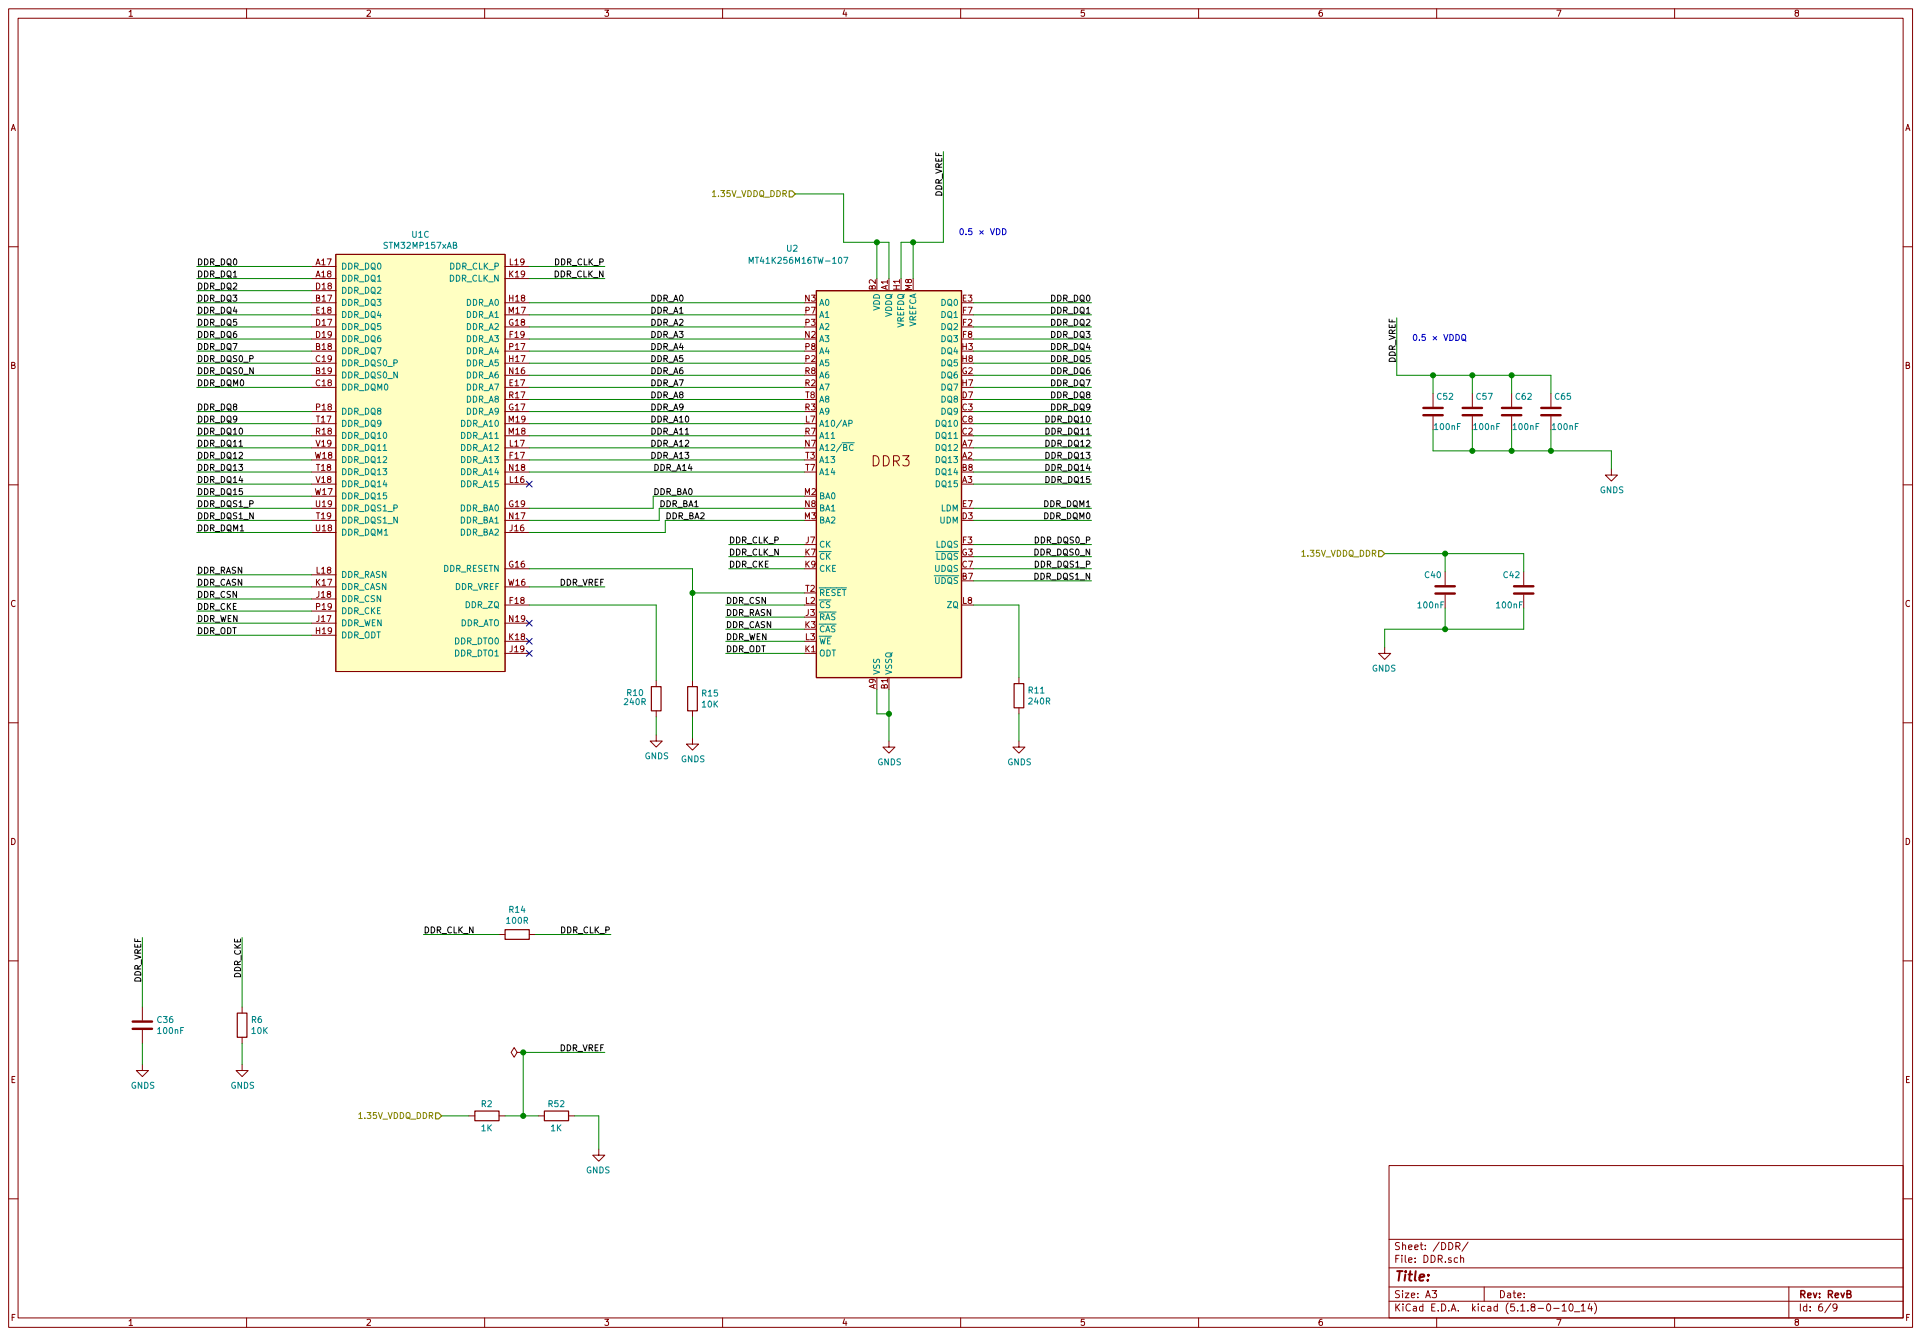
[picture p28: page 6]

Id: 6/9 Title: File: DDR.sch Sheet: /DDR/

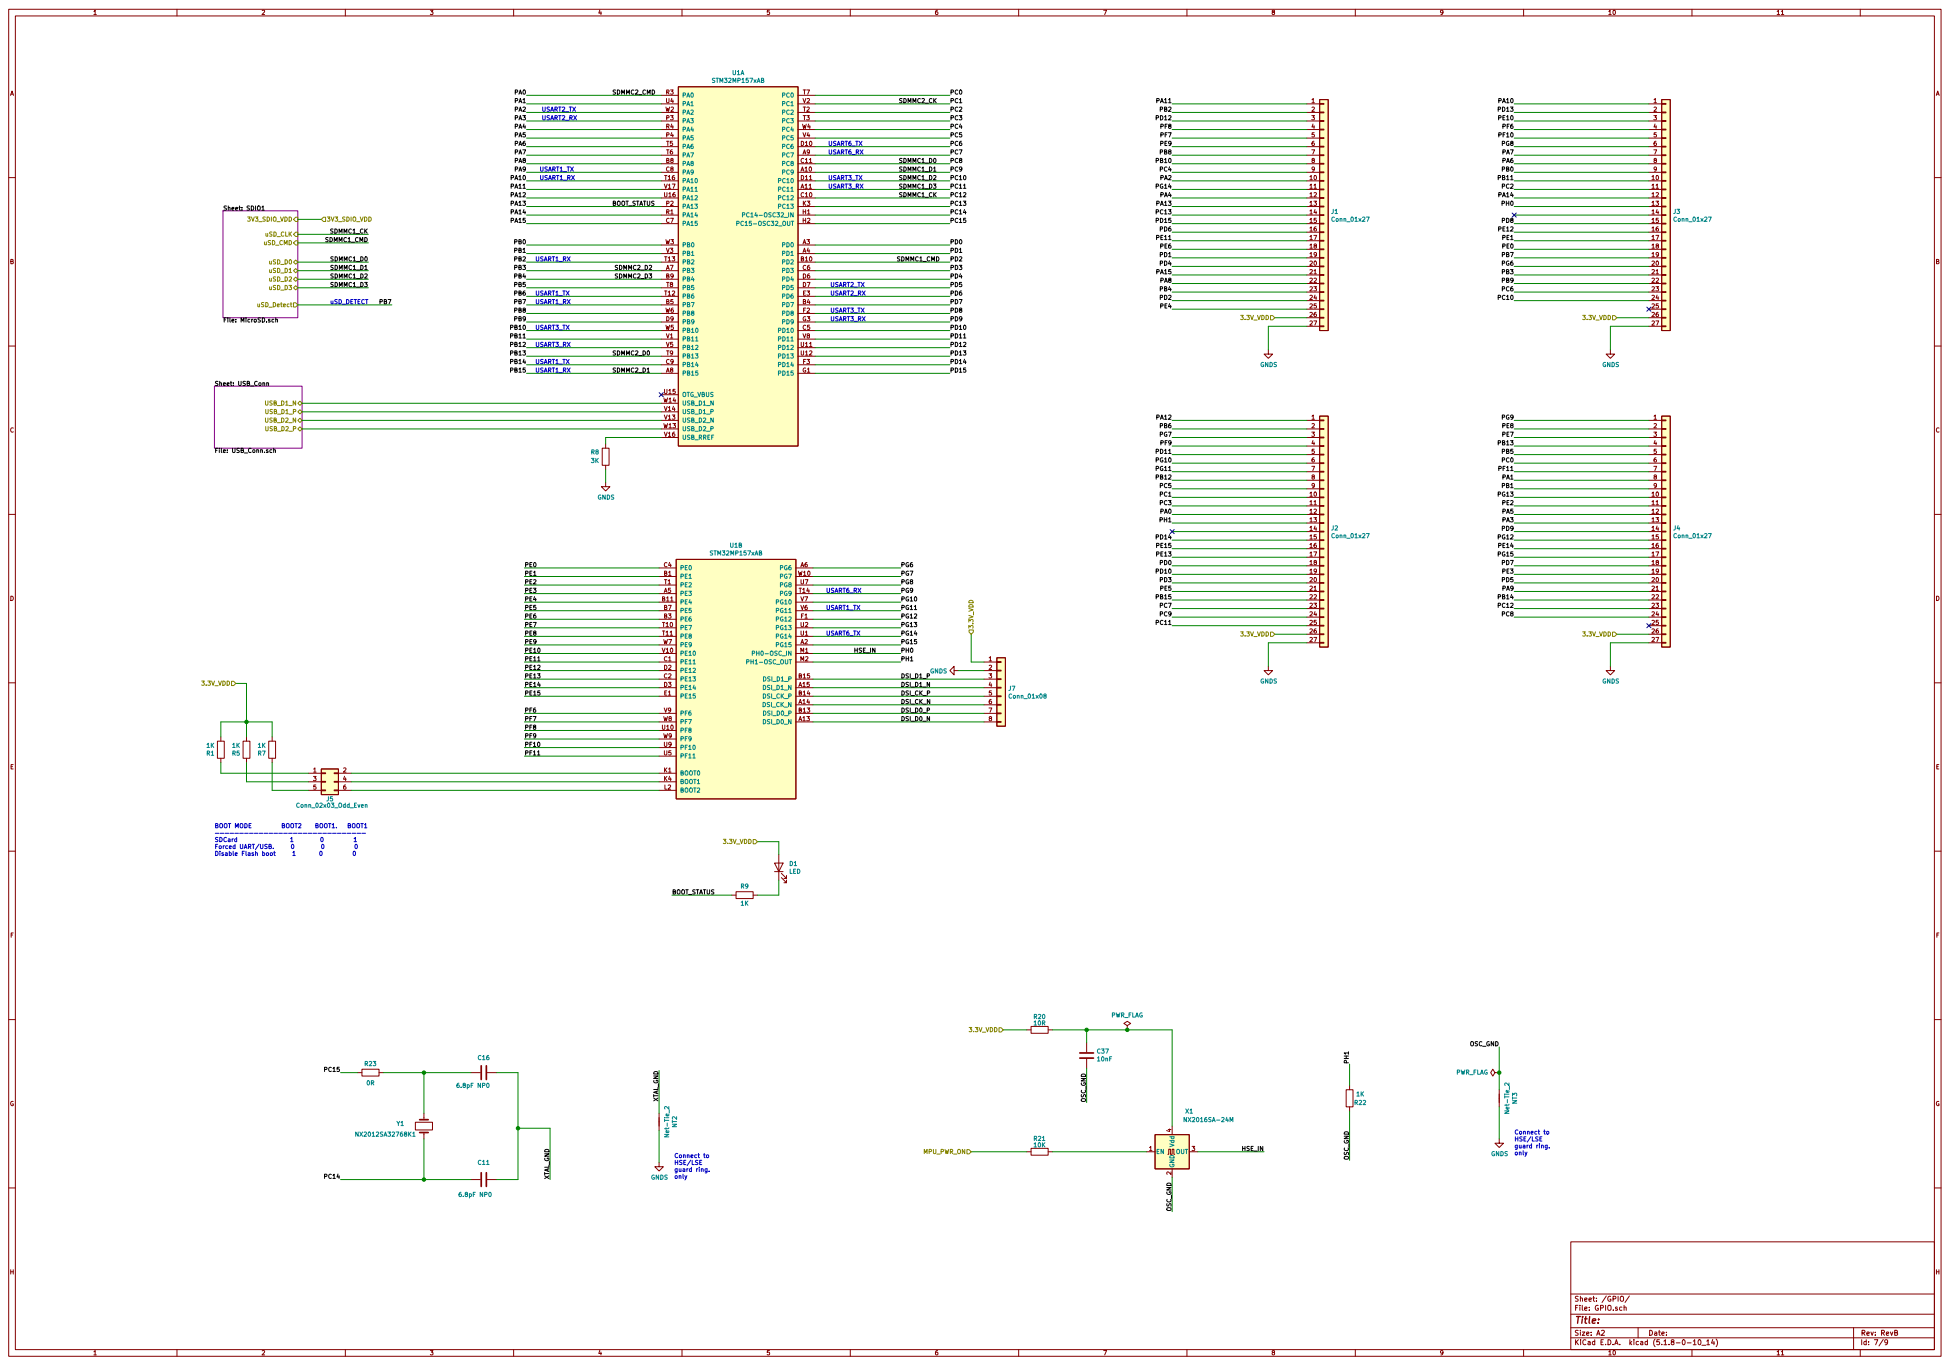
[picture p29: page 7]

Sheet: SDIO1 File: MicroSD.sch

Connect to HSE/LSE

Id: 7/9 Title: File: GPIO.sch Sheet: /GPIO/


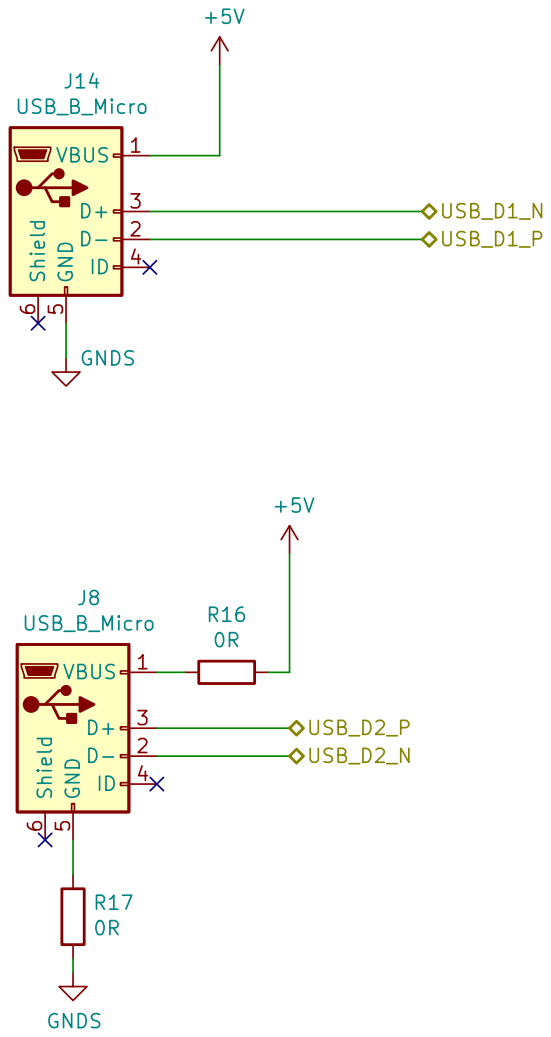
[picture p30: page 9]
