cracked-machine/STM32MP1_TestBoard_RevC/STM32MP1_TestBoard_RevC/PSU.sch

## KiCad design STM32MP1_TestBoard_RevC/PSU.sch (2021-08-06)

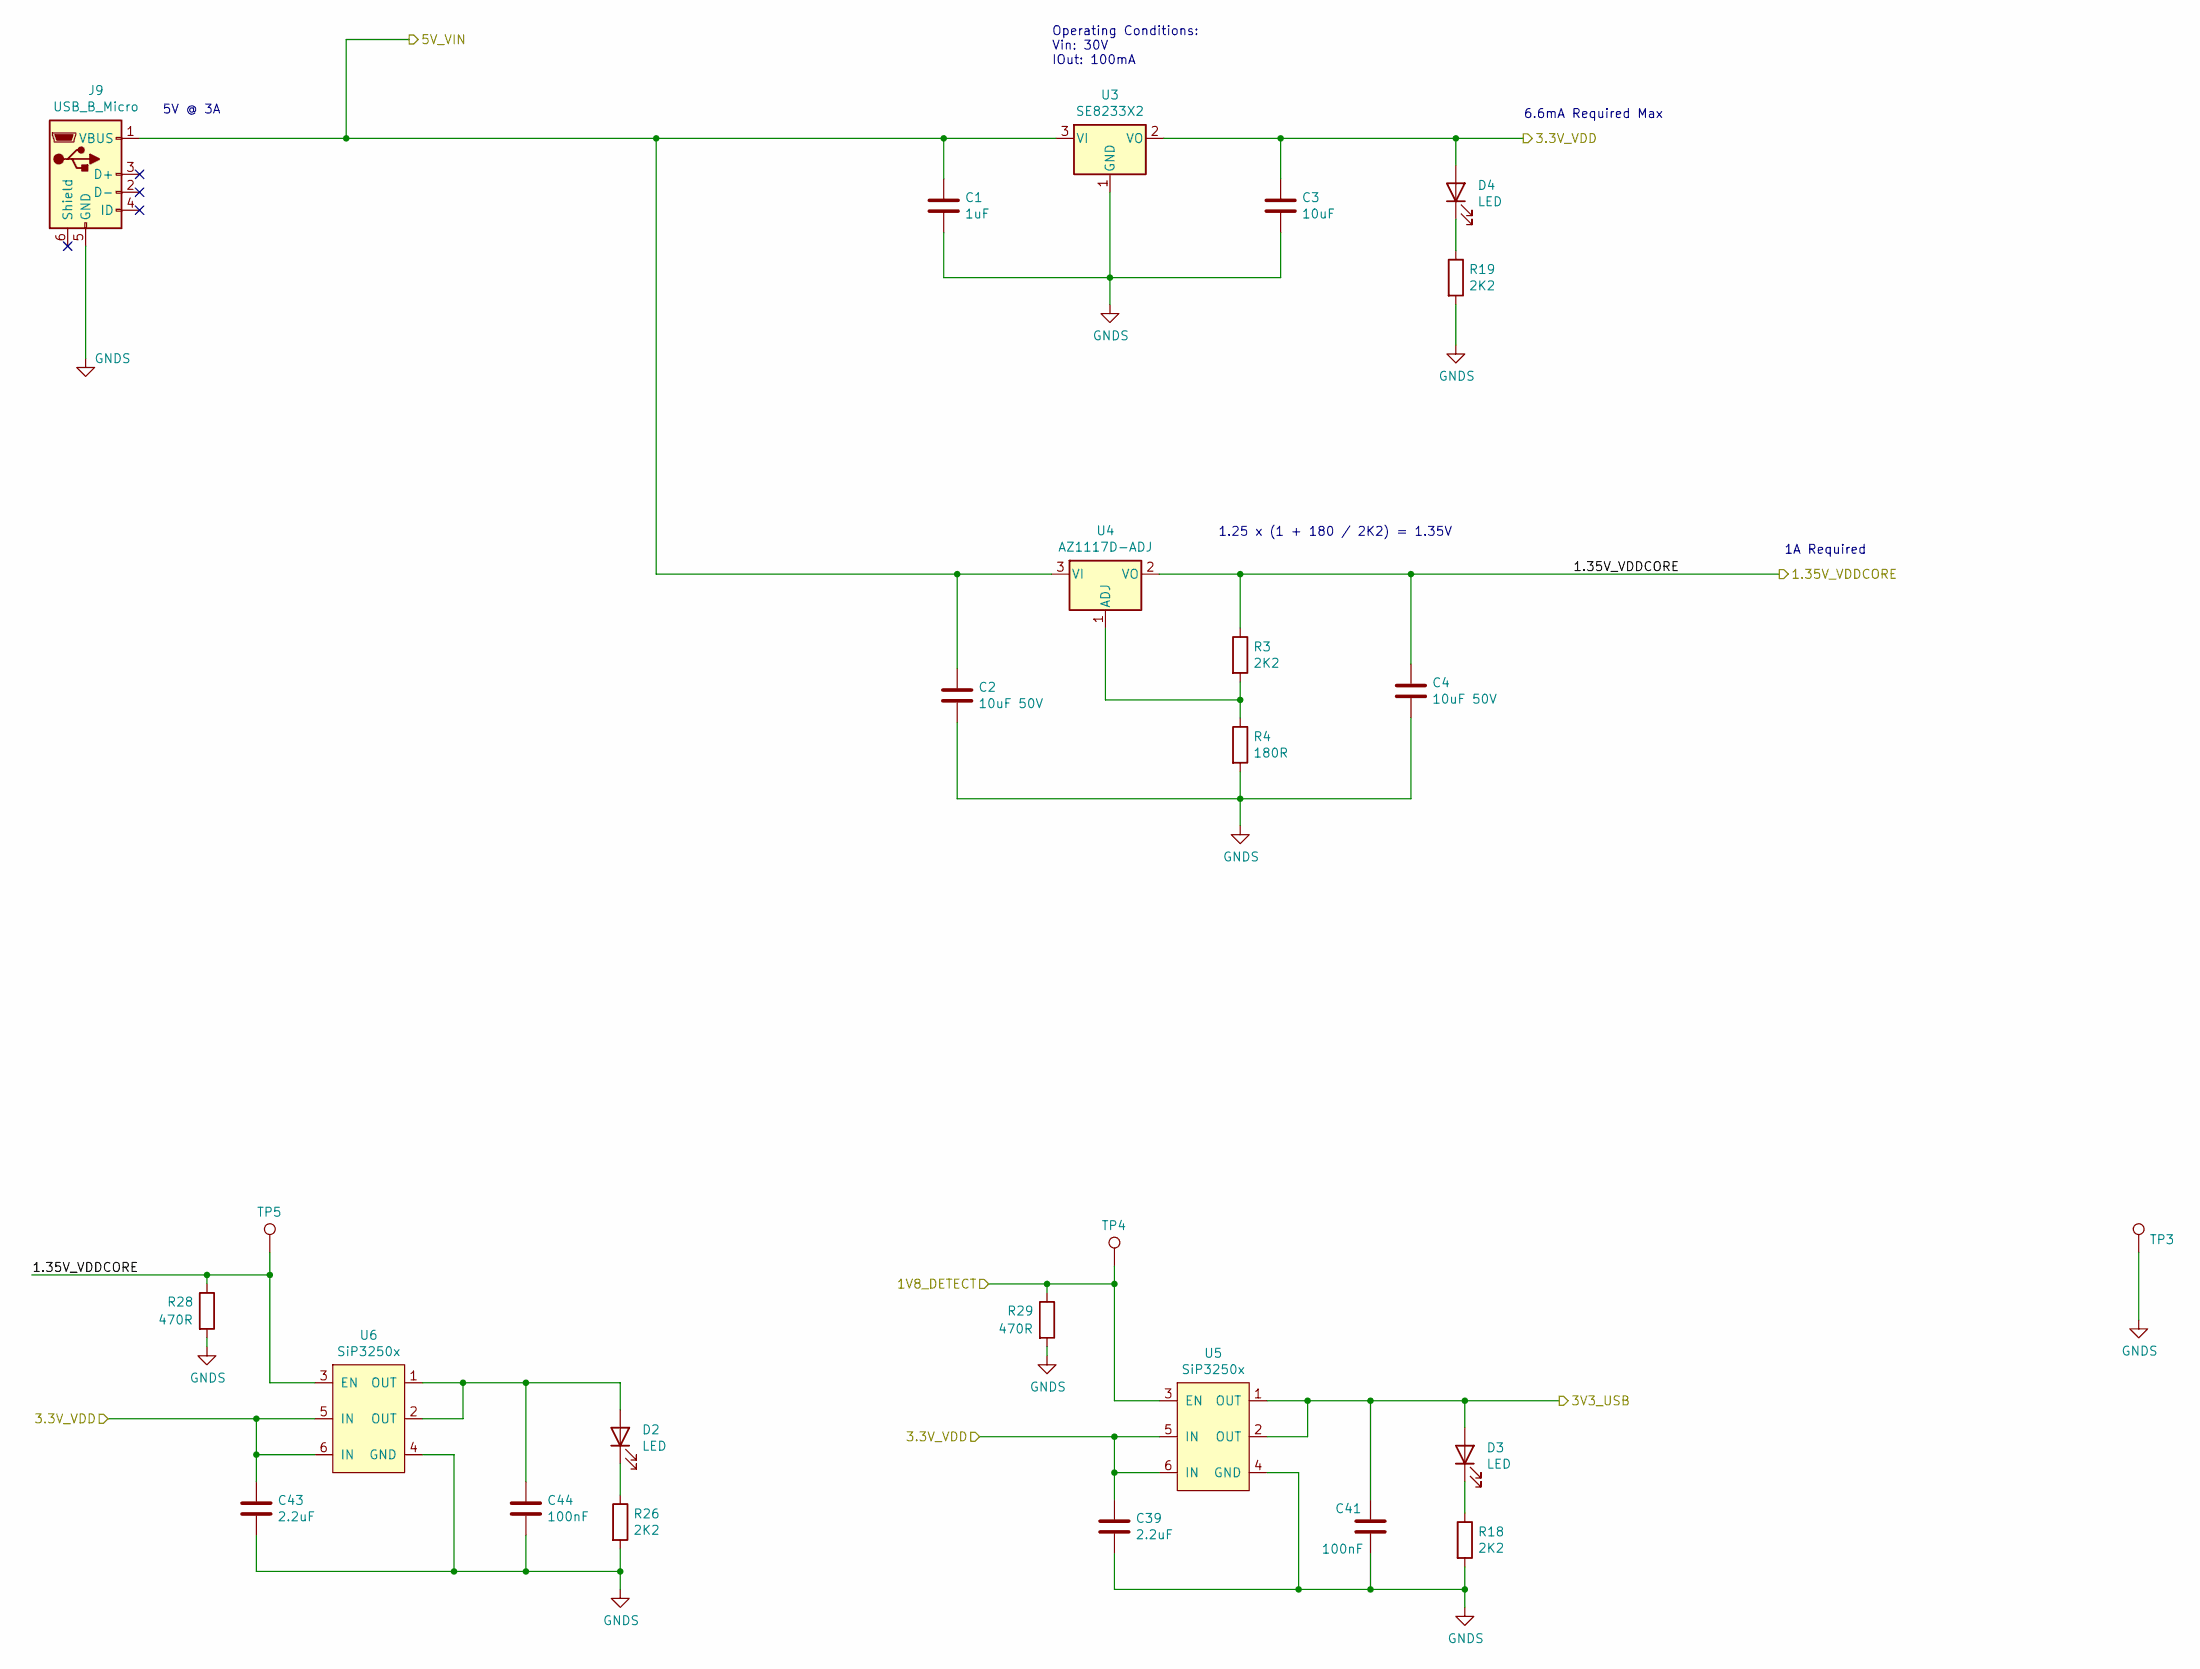
[picture p36: schematic PSU.sch]

Parts:
C1: 1uF; C_0402_1005Metric_Pad0.74x0.62mm_HandSolder; LCSC C52923
C2, C4: 10uF 50V; C_1206_3216Metric_Pad1.33x1.80mm_HandSolder; PartNo C1206C226M8PACTU
C3: 10uF; C_0402_1005Metric_Pad0.74x0.62mm_HandSolder; LCSC C15525
C39, C43: 2.2uF; C_0603_1608Metric_Pad1.08x0.95mm_HandSolder; LCSC C23630
C41, C44: 100nF; C_0402_1005Metric_Pad0.74x0.62mm_HandSolder; LCSC C1525
D2, D3, D4: LED; LED_0805_2012Metric_Pad1.15x1.40mm_HandSolder; LCSC C84256
J9: USB_B_Micro; USB_Micro-B_Molex-105017-0001
R3, R26: 2K2; R_0805_2012Metric_Pad1.20x1.40mm_HandSolder; LCSC C25879
R4: 180R; R_0805_2012Metric_Pad1.20x1.40mm_HandSolder; LCSC C25879
R18, R19: 2K2; R_0402_1005Metric_Pad0.72x0.64mm_HandSolder; LCSC C25879
R28, R29: 470R; R_0805_2012Metric_Pad1.20x1.40mm_HandSolder; LCSC C25879
TP3, TP4, TP5: TestPoint; TestPoint_Pad_D1.0mm
U3: SE8233X2; SOT-23
U4: AZ1117D-ADJ; TO-252-2
U5, U6: SiP3250x; SOT-23-6_Handsoldering; PartNo SIP32508DT-T1-GE3; Mouser 78-SIP32508DT-T1-GE3

Connections:
1.35V_VDDCORE: C4.1, R3.1, R28.1, TP5.1, U4.2 (VO), U6.3 (EN)
1V8_DETECT: R29.1, TP4.1, U5.3 (EN)
3.3V_VDD: C3.1, C39.1, C43.1, D4.2 (A), U3.2 (VO), U5.5 (IN), U5.6 (IN), U6.5 (IN), U6.6 (IN)
3V3_USB: C41.1, D3.2 (A), U5.1 (OUT), U5.2 (OUT)
5V_VIN: C1.1, C2.1, J9.1 (VBUS), U3.3 (VI), U4.3 (VI)
GNDS: C1.2, C2.2, C3.2, C4.2, C39.2, C41.2, C43.2, C44.2, J9.5 (GND), R4.2, R18.2, R19.2, R26.2, R28.2, R29.2, TP3.1, U3.1 (GND), U5.4 (GND), U6.4 (GND)
unnamed: C44.1, D2.2 (A), U6.1 (OUT), U6.2 (OUT)
unnamed: D2.1 (K), R26.1
unnamed: D3.1 (K), R18.1
unnamed: D4.1 (K), R19.1
unnamed: R3.2, R4.1, U4.1 (ADJ)

Notes on the sheet:
6.6mA Required Max
1A Required
Operating Conditions: Vin: 30V IOut: 100mA
1.25 x (1 + 180 / 2K2) = 1.35V
5V @ 3A
