cracked-machine/STM32MP1_TestBoard_RevC/STM32MP1_TestBoard_RevC/STM32MP1_TestBoard_RevC.sch

## KiCad design STM32MP1_TestBoard_RevC/STM32MP1_TestBoard_RevC.sch (2021-08-06)

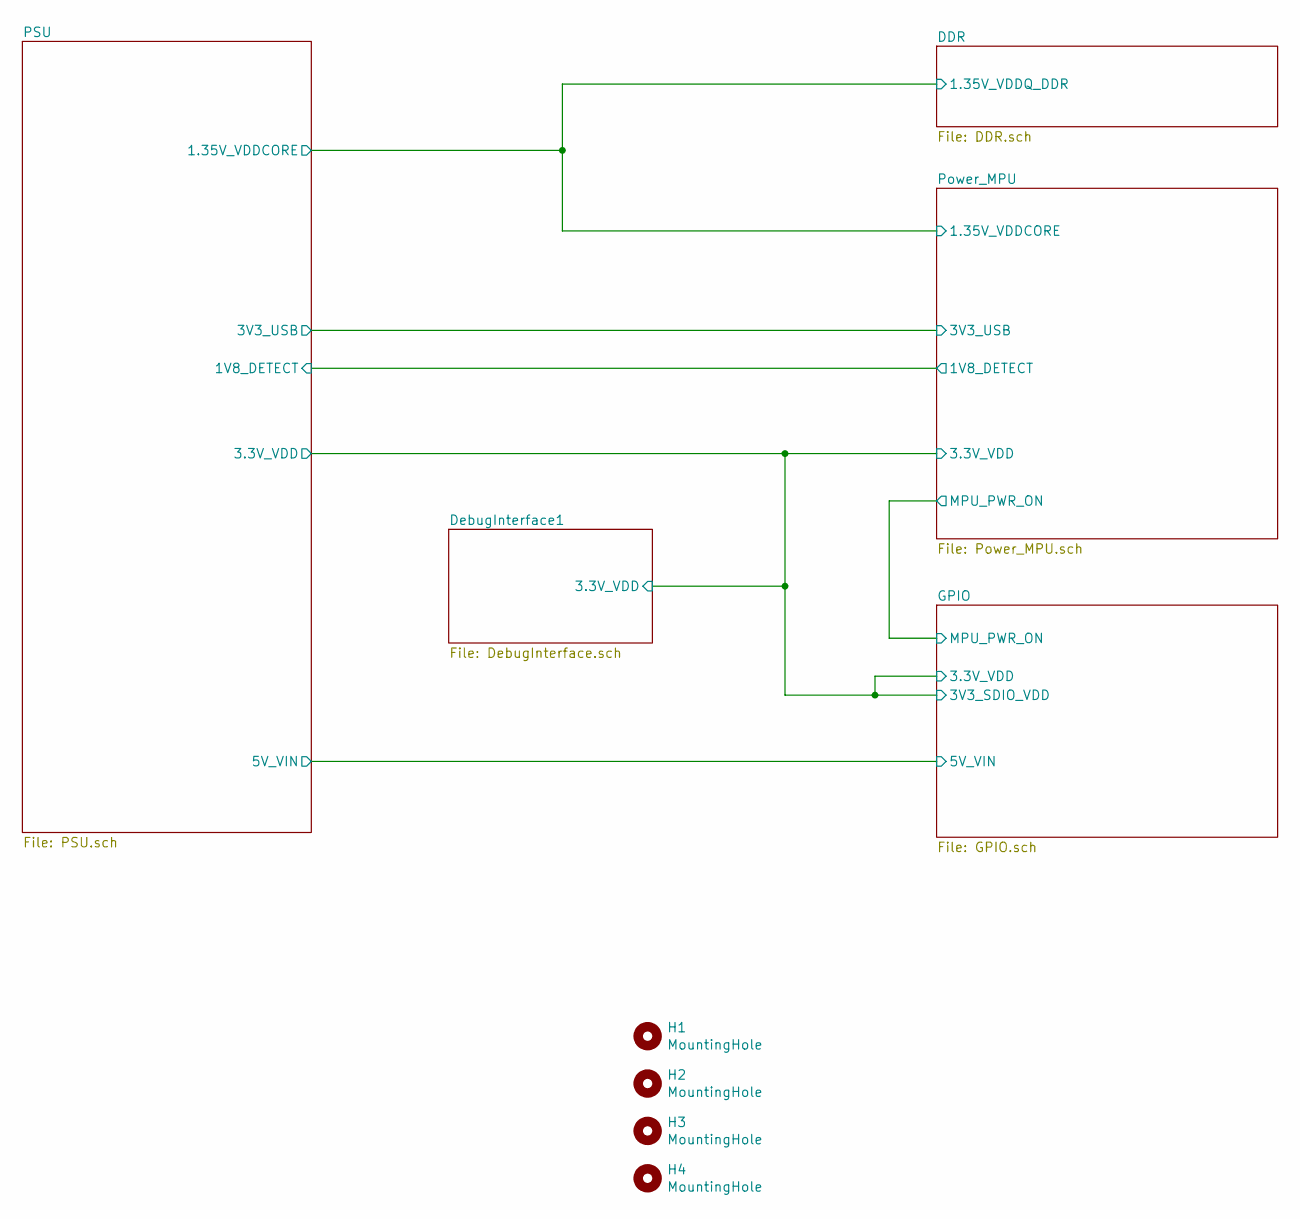
[picture p38: schematic STM32MP1_TestBoard_RevC.sch]

Parts:
H1, H2, H3, H4: MountingHole; MountingHole_2.2mm_M2_Pad_Via
