cracked-machine/STM32MP1_TestBoard_RevC/STM32MP1_TestBoard_RevC/USB_Conn.sch

## KiCad design STM32MP1_TestBoard_RevC/USB_Conn.sch (2021-08-06)

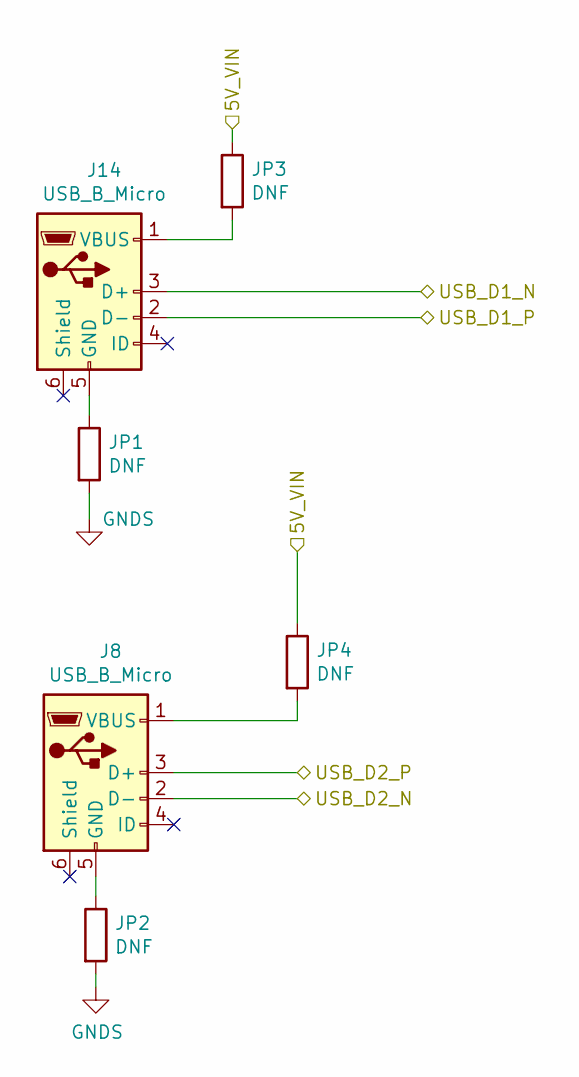
[picture p39: schematic USB_Conn.sch]

Parts:
J8, J13: USB_B_Micro; USB_Micro-B_Molex-105017-0001
JP1, JP2, JP3, JP4: DNF; R_0402_1005Metric_Pad0.72x0.64mm_HandSolder

Connections:
5V_VIN: JP3.1, JP4.1
GNDS: JP1.2, JP2.2
unnamed: J8.1 (VBUS), JP4.2
unnamed: J8.5 (GND), JP2.1
unnamed: J13.1 (VBUS), JP3.2
unnamed: J13.5 (GND), JP1.1
USB_D1_N: J13.3 (D+)
USB_D1_P: J13.2 (D-)
USB_D2_N: J8.2 (D-)
USB_D2_P: J8.3 (D+)
