cracked-machine/STM32MP1_TestBoard_RevC/(commit log)

2021-06-18 Fixed multiple issues:
    - Changed µSD Card connector footprint from Push-Pull Molex 104031-0811 to Push-Push Hirose DM3BT-DSF-PEJS.
    - Changed Buck Converter TPS42402 to TPS563200. Due to availability reasons.
    - Add pull-down resistors to 1.35V and 1.8V voltage rail LEDs. Ensures that they don't stay illuminated when no voltage rail is present.
    - Added M2 mounting holes
    [1040310811.stp, 1050170001.stp, 2137160001.stp, 475710001.stp, DC Power Jack 5.5mm x 2.1mm.STEP, DDR.sch, DM3BT-DSF-PEJS.stp, DebugInterface.sch]
2021-08-06 HW changes
    - Changed buck converter(TPS42402) to LDO (AZ1117)
    [DDR.sch, DebugInterface.sch, GPIO.sch, MicroSD.sch, PSU.sch, Power_MPU.sch, STM32MP1_TestBoard_RevC.sch, USB_Conn.sch]
